tthayer/rv_drone/docs/ENGINE.md

# rv_drone drone engine

The engine runs on the LicheeRV Nano's C906 core in `src/engine/`. It is plain
C11 float code with no libm and no hardware access, so the Mac emulator (`emu/`)
runs exactly the same code and produces the same audio. This document
describes what it does, how it is driven, and how it runs on the Nano.
`docs/ARCHITECTURE.md` covers the board-level system.

| File | Contents |
|---|---|
| `src/engine/engine.c`, `engine.h` | voices, filter, effects, MIDI clock follower, `engine_render()` |
| `src/engine/params.c`, `params.h` | the parameter table: ranges, curves, units, formatting, CC map, clock divisions |
| `src/engine/osc.c`, `osc.h` | oscillator-bank kernels: scalar and RVV (XTheadVector), same math |
| `src/engine/dsp.h` | libm-free math: `dsp_exp2`, `dsp_mtof`, `dsp_sin1`, `dsp_tanh`, `dsp_noise`, `dsp_flush` |
| `src/ui/ui.c` | encoder pages, MIDI routing, presets, display drawing; calls into the engine |
| `src/app/main.c` (`render_block`) | Nano glue: renders one rvlink block, converts it to 24-bit, measures the time it takes |

## Signal flow

```
 per voice (x4) ------------------------------------------------------------
  osc 1..N (N = OSCS, 3-7)                          per-voice filter LFO
  sine -> polyBLEP saw (SHAPE)                      (free Hz, or synced)
  detune spread + drift LFO ---> pan (SPREAD) --+           |
  sub: sine one octave down (SUB, centre) ------+--> stereo SVF (LP/BP, RESO)
                                                    --> tanh drive (DRIVE)
                                                    --> envelope (ATTACK/RELEASE)
 ---------------------------------------------------------------------------
 sum of voices x mix gain (1 up to 4 voices, then 2/sqrt(n))
  --> chorus (2 modulated taps per side, CHORUS)
  --> feedback delay (stereo, cross-fed, damped, DELAY/FEEDBACK/DLY MIX)
  --> FDN reverb (8 lines, SIZE/DAMP/REVERB; REV MODE: hall, shimmer, freeze)
        ^-- pitch shifter (+12 / +7 / -12 st) on the wet sum, fed back (SHIMMER)
  --> loop recorder (capture the post-effects signal, add the loop playback)
  --> volume (VOLUME^2, smoothed) --> soft clip --> L/R float, about +-1
```

The engine works in **32-frame control blocks**. Pitches, pans, envelope
coefficients, filter coefficients, LFO phases and effect settings are worked
out once per control block. Oscillators, filters, the envelope and the
effects run per sample. `engine_render(l, r, n)` accepts any `n` and splits it
into control blocks internally.

## Voices

- **Sixteen voices** (`ENGINE_VOICES`, 4 until 2026-10-07). Each voice holds
  one MIDI note (plus TRANSPOSE). The engine
  starts **silent**: `engine_init()` plays nothing until a note arrives, from
  MIDI or the emulator's keyboard. `emu --wav` defaults to `--notes 38,45`
  (D2 + A2), so offline renders still have a drone. Until 2026-10-07 the boot
  latched D2 + A2, so the hardware made sound with no MIDI attached.
- **Voice allocation for a note-on:**
  1. the voice already playing that note (it retriggers);
  2. otherwise a silent voice;
  3. otherwise **steal** the quietest releasing voice, else the quietest held
     voice (ties go to the oldest). The stolen voice **fades out over 30 ms**
     (`STEAL_FADE_S`) and then starts the new note with fresh phases and an
     attack from zero. If it is already near silent (below 1e-3), it switches
     at once. Before 2026-10-07 a steal changed the voice's note instantly,
     cutting its tail off.

  A voice that starts from silence gets random oscillator phases and drift
  rates, so no two notes start identically. A note-off for a note still
  queued on a fading voice cancels it.
- **LATCH ON (the default):** note-offs are ignored. The first note-on after
  all keys have been released starts a new chord, releasing the previous one.
  This holds a drone chord with no sustain pedal.
- **LATCH OFF:** note-offs release their voice, so an external sequencer can
  gate notes. CC 123 (All Notes Off) releases everything in either mode.

### Oscillator bank

- **Kernel:** each voice's bank renders a whole control block into stereo
  buffers in one call (`osc_bank_scalar` or `osc_bank_rvv`). Phases are 32-bit
  fixed point (2^32 = one cycle), so wrapping is exact and costs nothing, and
  sample i's phase is `ph + i·inc`, which is easy to vectorise.
- **Oscillator count:** OSCS, 3 to 16 per voice (7 until 2026-10-07). On the
  Nano, plain-C mode (RVV off) caps it at 7 to stay real-time.
- **Detune:** the oscillators are spread linearly across ±DETUNE cents. Each
  one also has its own **drift LFO**: a sine of ±(DRIFT × 10) cents at a
  random rate of 0.05–0.17 Hz. This slow beating is what makes the drone move.
- **STACK** sets an interval and level for each oscillator, cycling through
  the mode's table. Detune and drift still apply on top. An oscillator pushed
  above 0.45·fs is muted rather than mistuned.

  | STACK | Intervals (semitones) | Weights |
  |---|---|---|
  | UNISON | 0 | 1 |
  | OCTAVES | 0, +12, −12, +24 | 1, .7, .8, .5 |
  | FIFTHS | 0, +7, +12, +19, −12, +24 | 1, .8, .7, .55, .75, .45 |
  | ORGAN | 0, +12, +19, +24, +28, +31, +36, −12 (8′ 4′ 2⅔′ 2′ 1⅗′ 1⅓′ 1′ 16′) | 1, .8, .6, .55, .45, .4, .35, .7 |
- **Waveform:** a crossfade from sine to **polyBLEP saw**, set by SHAPE
  (0 = pure sine, 1 = band-limited saw).
- **WAVE (source):** ANALOG (the morph above) or a **band-limited single-cycle
  wavetable** in DDR — SAW, SQUARE, ORGAN, or a CUSTOM cycle loaded from
  `WAVE.RAW`. Each table has 10 MIP levels (harmonic caps 512…1); the
  oscillator selects the level whose harmonics stay under Nyquist for its pitch,
  so there is no aliasing. The lookup is **scalar**: XTheadVector has no indexed
  load, so wavetable notes use the scalar path even when the RVV kernels are
  selected (SHAPE is ignored for a wavetable).
- **Stereo:** neighbouring oscillators are panned to opposite sides with an
  equal-power law; SPREAD sets the width.
- **Level:** the bank is normalised by roughly 1/√N, so changing OSCS doesn't
  jump the level.
- **Sub:** a sine one octave below the root, level SUB × 1.2, panned to the
  centre and added before the filter.

### Filter, drive, envelope

- **Filter:** a stereo **TPT state-variable filter** (Zavalishin topology:
  stable when modulated, no delay-free-loop problems).
  - MODE selects LP, or BP with its gain normalised to the peak.
  - The damping is k = 2 − 2·RESO, with RESO from 0 to 95 %.
  - The coefficient g = tan(π·fc/fs) comes from the `dsp_sin1` ratio.
- **Cutoff:** CUTOFF, smoothed per control block so encoder steps don't
  zipper, times 2^(MODDEPTH × 3 × lfo), so modulation reaches up to
  ±3 octaves. The result is clamped to 20 Hz … 0.42·fs.
- **Filter LFO:** one sine per voice.
  - Free-running, its rate is MODRATE × (1 + 0.13·voice index), so the voices
    drift apart.
  - Synced to MIDI clock, see below. Voices are then offset by ¼ cycle.
- **Drive:** `tanh_approx(x × (1 + 3·DRIVE)) / (1 + DRIVE)` on each channel
  after the filter.
- **Envelope:** a one-pole glide towards its target: the note's velocity gain
  (the MIDI velocity / 127, so 0.008…1) while the gate is on, or 0 while it is
  off. The per-sample coefficient 1 − e^(−1/τ) is computed with a series expansion for
  long times, because 1 − 2^(−tiny) loses all precision. Until 2026-10-07
  `dsp_exp2`'s Taylor error made every long ATTACK and RELEASE about 6× too
  short. The time
  constant is ATTACK/3 or RELEASE/3, so the level is about 95 % of the way
  there after ATTACK or RELEASE seconds. A voice is freed when its level falls
  below 1e-4 with the gate off.

## Effects (shared)

The summed voices are scaled by a smoothed mix gain into the effects chain:
1 for up to 4 sounding voices (as before), then 2/√n (0.5 at 16), so a full
chord doesn't push the output into the clipper. It used to be a fixed ×0.45,
now folded into the voice-path gain.

- **Chorus:**
  - Two linearly interpolated taps per channel, at 12 ms ± 4 ms.
  - Modulated by a 0.23 Hz LFO in quadrature (L and R a quarter-cycle apart).
  - Cross taps at 1.37× the opposite channel's delay.
  - Output: `out += CHORUS × 0.6 × (tap + cross tap)`.
- **Delay:**
  - Stereo with cross-fed feedback (ping-pong-like) and a one-pole lowpass in
    the loop, so repeats darken.
  - Up to 120 s; DELAY sets the time in free mode. The buffer is 2^23 samples
    per channel (~175 s, 64 MiB stereo) out of the spare DDR; the delay streams
    from it sequentially, so the CPU cost is unchanged.
  - The time glides (0.0005 per sample), so changing it bends the pitch like
    tape instead of clicking.
  - FEEDBACK goes up to 95 %; DLY MIX sets the wet level.
- **Reverb:** an 8-line **feedback delay network**.
  - Line lengths: primes from 1031 to 2969 samples, scaled by
    (0.5 + 1.3·SIZE).
  - Orthonormal Hadamard mixing (fast in-place butterflies, ×1/√8).
  - Each line has its own gain for an RT60 of 1.5 + 12·SIZE² seconds, and a
    one-pole damping lowpass set by DAMP.
  - Input goes to the lines with alternating signs. Even lines feed L, odd
    lines feed R. REVERB sets the wet level.
  - **REV MODE** picks how the reverb behaves:

    | Mode | What it does |
    |---|---|
    | HALL | the plain FDN above |
    | SHIM OCT | shimmer: the wet sum, shifted up 12 st, is fed back into the input |
    | SHIM 5TH | the same, shifted up 7 st (×1.4983) |
    | SUB OCT | the same, shifted down 12 st, a darker bloom |
    | FREEZE | input fades out (about 20 ms), line gains go to 0.99998 and damping off, so the current tail holds for minutes; the dry sound still plays on top |

  - **Shimmer pitch shifter:** two taps on a 8192-sample buffer of the wet
    sum (L+R). Each tap's delay sweeps across 4096 samples (85 ms) at a rate
    set by the pitch ratio, half a sweep apart, with Hann crossfades that sum
    to 1. The shifted signal goes through a one-pole lowpass (about 4.6 kHz),
    a one-pole highpass (about 77 Hz) and `tanh`, then into every line's
    input. SHIMMER scales it, smoothed so mode changes don't click. Repeated
    passes stack octaves (or fifths) upward, each quieter than the last.
  - Like any delay-line shifter it detunes a pure sine by a few Hz (the
    grain rate) and beats slightly; the reverb smears that into the shimmer.
    More taps or longer sweeps were tried and cancel the shifted tone on
    some notes.
  - **Feedback limit:** a host sweep (3-note chord, every shimmer mode,
    SIZE 0–1, DAMP 0 and 50 %, SHIMMER 100 %) found the loop sustains itself
    above a gain of 0.19 at worst (SHIM OCT, DAMP 0, SIZE 75 %). `SHIM_FB`
    is 0.15 at SHIMMER 100 %, so every tail still decays. The shifted band
    lands 6–16 dB below the played note.
- **Output:** volume is VOLUME², smoothed per sample, times `OUT_GAIN` (0.4),
  then `tanh_approx` soft-clips into ±1.
  - The gain is sized from measurement: the worst case (16 voices × 7 osc,
    drive 60 %, reso 90 %, VOLUME 100 %) peaks at about 2.7× full scale before
    this stage, so 0.4 lands it at −4 dBFS and the clipper is only a safety
    net. Default settings sit around −9 dBFS.
  - It was ×1.5 until 2026-10-07, which clipped hard even at 4 voices.
    Presets saved before then play about 11 dB quieter; the default VOLUME
    moved from 70 % to 85 % to compensate.

## Loop recorder

The LOOPER page records the post-effects output into a large buffer, loops it,
and layers overdubs — spare DDR, like the long delay. RAM is the only real
cost; the buffer streams sequentially.

- One buffer of 2^22 frames per channel (~87 s, 32 MiB stereo). The first
  record pass sets the length (stopped when REC is toggled off); left running,
  the buffer fills over ~87 s and then plays.
- **Capture point:** the post-effects signal, just before the master volume
  (`l`/`r` after the reverb in the signal flow above). Playback is summed back
  at the same point, so a loop sits at the same level as the live signal.
- **Overdub** plays the loop and adds the new input on top (`buf += in`), so
  passes layer without runaway feedback.
- **Transport & UI:** the LOOPER page's switches are REC, PLAY/STOP and DUB;
  encoder 1 picks the slot, and SAVE/LOAD stream the loop to/from the SD card
  (`LOOP0n.RAW`, raw float32: an L plane then an R plane; `build/emu/loops/` in
  the emulator). Starting REC again clears and re-records.
- **CPU:** one read and one write per sample per channel, streaming from DDR —
  negligible next to the delay.

## MIDI clock follower

The MicroFreak (or any MIDI clock master) sets the tempo. Pico B timestamps
every clock byte in its UART interrupt and forwards it to the Nano as an
rvpanel `CLOCK` packet. See `docs/ARCHITECTURE.md`, "Panel link".

- **Tempo:** the mean of the last 24 tick intervals (one beat at 24 PPQN),
  from Pico B's timestamps, so link jitter doesn't reach it. An interval over
  250 ms restarts the average. The tempo counts as valid once there are 4
  intervals and the last tick was under 0.5 s ago.
- **Beat position:** advances every control block at the measured tempo. On
  each tick it is pulled 25 % of the way onto the tick grid, or snapped if it
  is more than a beat off. **Start** resets it so the next tick is beat 0.
  Stop and Continue only switch the "running" indicator.
- **What the clock drives** (CLOCK page, SYNC = MIDI, with a valid tempo):
  - LFO DIV sets one filter-LFO cycle per ¼ beat, ½ beat, 1 beat, 2 beats,
    1 bar, 2 bars, 4 bars or 8 bars. The LFO phase comes straight from the beat
    position.
  - DLY DIV sets the delay to 1/16, 1/8, dotted 1/8, 1/4, dotted 1/4 or 1/2,
    capped at 2 s.
  - FREE in either setting keeps the Hz or millisecond parameter.
- **Without a clock** (no tick for 0.5 s), everything falls back to the free
  values. The header shows `120>BPM` while the clock is running and `120 BPM`
  while it is stopped.
- **Verified on hardware** (2026-10-07) with the MicroFreak as master. It
  only sends MIDI clock while its arpeggiator or sequencer is playing, and
  Utility → MIDI → Output dest must be MIDI or BOTH. The Nano tracked 176 BPM
  (about 70 ticks/s), and the LFO divider audibly locked to the bar.
- **Checked in emu:** at 120 BPM with 1 BAR, the filter-LFO period measures
  2.02 s. At 90 BPM with 2 beats, it measures 1.33 s.

## Parameters

Each parameter has a **normalised position** (0–1, which is what an encoder
moves and what presets store) and a **value** in its own unit (what the engine
uses). EXP parameters are spaced logarithmically. INT and ENUM parameters move
exactly one step per encoder click, and ENUMs wrap around.

| Page | Param | Range | Default | Curve | CC |
|---|---|---|---|---|---|
| OSC | DETUNE | 0–50 cents | 12 c | lin | 20 |
| OSC | DRIFT | 0–100 % (±10 c) | 30 % | lin | 21 |
| OSC | SHAPE | sine → saw | 60 % | lin | 22 |
| OSC | OSCS | 3–16 | 5 | int | 23 |
| OSC | SUB | 0–100 % | 30 % | lin | 24 |
| OSC | SPREAD | 0–100 % | 70 % | lin | 25 |
| FILTER | CUTOFF | 40 Hz–12 kHz | 900 Hz | exp | 26, **74** |
| FILTER | RESO | 0–95 % | 30 % | lin | 27, **71** |
| FILTER | MODRATE | 0.01–2 Hz | 0.07 Hz | exp | 28 |
| FILTER | MODDEPTH | 0–100 % (±3 oct) | 35 % | lin | 29, **1** |
| FILTER | DRIVE | 0–100 % | 25 % | lin | 30 |
| FILTER | MODE | LP / BP | LP | enum | 31 |
| SPACE | CHORUS | 0–100 % | 40 % | lin | 32, **93** |
| SPACE | DELAY | 20 ms–120 s | 850 ms | exp | 33 |
| SPACE | FEEDBACK | 0–95 % | 55 % | lin | 34 |
| SPACE | DLY MIX | 0–100 % | 25 % | lin | 35 |
| SPACE | SIZE | 0–100 % | 75 % | lin | 36 |
| SPACE | REVERB | 0–100 % | 45 % | lin | 37, **91** |
| AMP | ATTACK | 10 ms–20 s | 2 s | exp | 38, **73** |
| AMP | RELEASE | 50 ms–30 s | 4 s | exp | 39, **72** |
| AMP | LATCH | OFF / ON | ON | enum | 40 |
| AMP | TRANSPOS | −24…+24 st | 0 | int | 41 |
| AMP | DAMP | 0–100 % | 50 % | lin | 42 |
| AMP | VOLUME | 0–100 % (squared) | 85 % | lin | 43, **7** |
| MODES | SYNC | OFF / MIDI | MIDI | enum | 44 |
| MODES | LFO DIV | FREE, 1/4 … 8 BAR | FREE | enum | 45 |
| MODES | DLY DIV | FREE, 1/16 … 1/2 | FREE | enum | 46 |
| MODES | STACK | UNISON, OCTAVES, FIFTHS, ORGAN | UNISON | enum | 47 |
| MODES | REV MODE | HALL, SHIM OCT, SHIM 5TH, SUB OCT, FREEZE | HALL | enum | 48 |
| MODES | SHIMMER | 0–100 % (shimmer modes only) | 50 % | lin | 49 |
| WAVE | WAVE | ANALOG, SAW, SQUARE, ORGAN, CUSTOM | ANALOG | enum | 50 |

CC values 0–127 map to a position of 0–1. CC 123 is All Notes Off.

**UI** (the player's guide is `docs/CONTROLS.md`): the six encoders show the six parameters of the current page; each
display shows two. Pushing encoder 1 steps through OSC → FILTER → SPACE → AMP
→ MODES → PRESET. Pushing any other encoder resets its parameter to the
default. The PRESET page is described in the README ("SD card and presets"):
encoder 1 picks the slot, encoder 2 loads and encoder 3 saves. The right
display previews the selected slot's stored settings: cutoff/reso, shape/detune,
oscs/sub, delay (time or division)/feedback, reverb/size, attack/release. The
file is read when the page opens, when the slot changes and after a save,
never from the draw path.
Presets store every parameter's position by name, so adding a parameter later
doesn't break older files. Files written since 2026-10-07 carry a `preset v2`
header. Older v1 files stored OSCS as a position on the old 3–7 range, so they
are converted on load to the same oscillator count.

## Running on the Nano

- **Where it runs:** `render_block()` in `src/app/main.c` is the rvlink render
  callback. The audio link calls it **from the main loop** right after each
  SPI frame, to have the next 64-frame block ready before Pico A asks for it.
  It renders, clamps, converts to 24-bit left-aligned `int32` and times the
  work with `rdtime`.
- **Float stays out of interrupts.** The trap entry doesn't save FP
  registers, so the engine, `ui_*` and the parameter code must only run in
  main-loop context. Check with
  `riscv64-elf-objdump -d build/nano/rv_drone.elf`: FP instructions should
  appear only in engine, UI, params and render functions. `main()` sets
  `sstatus.FS`.
- **Concurrency:** UI events (encoders, MIDI, clock) also reach the engine
  from the main loop, so engine state never needs locking on the Nano. The
  emulator locks the SDL audio device around UI calls instead.
- **SD stalls:** long SD waits call `audio_link_poll()` as an idle hook, so
  rendering continues while a preset saves.
- **Latency:** Pico A's buffer is primed to 3 blocks. With one block in
  flight, that's about 5.3 ms from render to DAC (it was 6.7 ms at 4 blocks). MIDI note and parameter changes take effect at
  the next render, so they're quantised to block boundaries of 1.33 ms.
- **CPU cost** (C906, `-O2`, no vector instructions yet), per 64-frame block
  out of a 1333 µs budget:

  | Load | Time | CPU |
  |---|---|---|
  | silent (effects only) | ~93 µs | 7 % |
  | 2 voices × 5 osc (a D2 + A2 drone), M7 build | ~290 µs | 21 % |
  | 4 voices × 7 osc, M7 build | ~444 µs | 33 % |
  | 16 voices × 7 osc, RVV | ~390 µs | 29 % |
  | 16 voices × 7 osc, scalar | ~976 µs | 73 % |
  | **16 voices × 16 osc (worst case, console `w`), RVV** | **~648 µs** | **48 %** |
  | 16 voices × 16 osc, scalar, uncapped | ~1795 µs | 134 %, not real-time, hence the scalar cap of 7 |
  | 16 voices × 16 osc requested, scalar, capped at 7 | ~1001 µs | 75 % |

  The effects cost about 140 µs per block whatever the voice count. That figure
  is inferred from the measurements above, not measured on its own. The
  console prints the render average, maximum and load each second, and the
  right display's header shows the load.
- **Memory** (static `.bss`, about 65 MiB, mostly the delay; `.bss` is `NOLOAD`
  so `fip.bin` stays ~360 KB — the `.bss` zeroing at boot just takes a little
  longer):

  | Buffer | Size |
  |---|---|
  | delay | 2 × 8388608 floats = 64 MiB |
  | loop | 2 × 4194304 floats = 32 MiB |
  | wavetables | 4 × 10 × 1025 floats = 160 KiB |
  | reverb | 8 × 8192 floats = 256 KiB |
  | shimmer | 8192 floats = 32 KiB |
  | chorus | 2 × 2048 floats = 16 KiB |

- **Cores and caches** (SG2002 TRM, Diagram 2.1 "System Framework" and §2.3.1):
  - **main C906 @ 1.0 GHz** (what we run): 32 KB I-cache, 64 KB D-cache and
    **128 KB L2** (Diagram 2.1), vector + FPU. The §2.3.1 list mentions the L2
    only under the A53; the diagram shows it for the main C906 as well, most
    likely the same L2 serving whichever main core boots.
  - **Cortex-A53 @ 1.0 GHz**, the alternative main core chosen by a boot pin
    (GPIO_RTX / EPHY_RTX): 32/32 KB L1 + 128 KB L2, NEON + FPU.
  - **coprocessor C906 @ 700 MHz** (parked today): **16 KB I-cache, 16 KB
    D-cache, no L2** (Diagram 2.1), FPU, no vector unit.
  - **8051** (RTC domain): 25–300 MHz, 8 KB SRAM, for power management.
  - **Core clock** (`src/hal/cpuclk.c`, build option `CPU_MHZ`, default 1000):
    - **Reset default:** the TRM clock table gives `clk_c906_0` fpll / 2 =
      **750 MHz** (`div_clk_c906_0_1`, `clk_sel_0[23] = 0`).
    - **Measured (2026-10-07): the vendor FSBL already runs the core at
      1050 MHz.** It sets MPLL to 25 × 42 = 1050 MHz (`mpll_csr` 0x05548101),
      selects it through `div_clk_c906_0_0` (0x00010309) and sets
      `clk_sel_0` to 0x01800000. With `CPU_MHZ=1000` the boot sees "already
      within 10 %" and leaves it alone. Every CPU figure in this document is at
      1050 MHz.
    - **What boot does:** it measures the core clock (`rdcycle` against the
      25 MHz `rdtime` over 2.5 ms, with a trap probe in case S-mode can't read
      the cycle counter). With `CPU_MHZ=1000` it then moves the core to
      **MPLL / 1** via `div_clk_c906_0_0` (src 3 = MPLL, ÷1) and
      `clk_sel_0[23] = 1`, but only if all of these hold:
      1. MPLL is powered (`pll_g6_ctrl[0] = 0`);
      2. MPLL is locked (`pll_g6_status[16]`);
      3. MPLL computes to 900–1100 MHz from its registers (fractional
         synthesizer or integer mode);
      4. the core isn't bypassed to the crystal (`clk_byp_1[6]`).
    - **Afterwards:** it re-measures and switches back if the result is more
      than 10 % off target. The banner prints `cpuclk: C906 <before> MHz at boot
      -> <after> MHz (…)` plus the register values. Console `c` re-measures.
    - **Nothing else moves:** the UARTs, SPI2, SD and the timer have their own
      clocks.
  Working sets (reuse distance, the live data between a write and its
  read-back):

  | Stage | Live working set | Main C906 (64 KB L1D + 128 KB L2) | Coprocessor (16 KB L1D, no L2) |
  |---|---|---|---|
  | oscillators, filter, envelope | < 1 KB | L1 | L1, a good fit |
  | chorus | 16 KB | L1 / L2 | misses |
  | reverb | Σ line lengths × 4 B: ~70 KB at SIZE 75 %, ~85 KB at 100 % | fits L2 | misses |
  | delay | delay time × 2 ch × 4 B: 326 KB at 850 ms, 23 MB at 60 s | streams from DDR (sequential) | streams from DDR |

  - **Effects stay on the main core** (with the vector kernels).
  - **If the coprocessor is used,** its FPU suits voice or oscillator work in
    scalar C, which has a tiny working set. It would hand each block back as
    512 B with a cache clean and invalidate, since the L1s are not coherent.
  - **If profiling shows the delay is memory-bound,** store it as 16-bit or
    make sure the T-Head prefetcher is enabled.
  - **Large random-access tables** (wavetables, granular) belong on the main
    core and must fit its 128 KB L2.
  The delay, chorus and reverb read positions use integer index arithmetic, so
  the 32-bit write counters never lose precision over long runs.
- **Numerics:**

  | Function | Accuracy |
  |---|---|
  | `dsp_exp2` | relative error 8e-8 (degree-6 minimax; was a Taylor fit at 1e-4 until 2026-10-07) |
  | `dsp_sin1` | absolute error 0.0011 |
  | `dsp_tanh` | a rational soft clipper, deliberately not exact tanh (max difference 0.024) |

  Feedback paths flush values below 1e-15 to zero (`dsp_flush`), so
  denormals can't build up.

## SIMD (RVV) and profiling

- **Vector unit:** the C906 implements RVV **0.7.1** (T-Head "XTheadVector",
  VLEN 128). GCC 16 targets it with `-march=rv64gc_xtheadvector` and the
  standard `__riscv_*` intrinsics, which compile to `th.v*` instructions. It
  does **not** auto-vectorise for this target, so vector code is written by hand.
  Only `src/engine/osc.c` and `src/hal/vec.c` are compiled with that `-march`
  (Makefile, `BOARD=nano`), so no other code can pick up vector instructions.
- **Enabling it:** `vec_init()` (`src/hal/vec.c`) runs at boot.
  - It tries `th.vsetvli`, catching the illegal-instruction trap.
  - If that traps, it sets the vector-state field in `sstatus`, first at
    T-Head's position (bits 24:23), then at the RVV 1.0 position (bits 10:9),
    and retries.
  - The console reports the result (`simd: vector unit ok, VLEN 128, …`).
- **C906 scalar tuning:** the Nano build defaults to `C906_OPT=1`, which
  means `-march=rv64imafdc_zicsr_zifencei_xthead{ba,bb,bs,cmo,condmov,fmemidx,mac,memidx,mempair,sync}`
  plus `-mtune=thead-c906`. It is equivalent to `-mcpu=thead-c906`, so GCC uses
  T-Head's scalar extensions and the C906 pipeline model:
  - indexed float loads and stores (`th.flrw`/`th.fsrw`) for the delay-line
    and buffer taps;
  - conditional moves (`th.mveqz`/`th.mvnez`) instead of branches;
  - paired loads and stores (`th.ldd`/`th.sdd`).

  These need `mxstatus.THEADISAEE`, which the vendor FSBL sets; the M5
  cache-maintenance probe relies on it too. `C906_OPT=0` builds generic
  `rv64gc` for A/B timing. The boot banner shows which build is running
  (`rv_drone [c906]` or `[rv64gc]`), and a flags stamp forces a full rebuild
  when the setting changes.
- **Self-test before use:** at boot the Nano runs the scalar and RVV
  oscillator kernels on the same random 7-oscillator bank for 8 blocks and
  compares them. The RVV kernel is used only if the largest difference is under
  1e-4 and the phases match exactly. Otherwise the engine stays scalar.
- **The same rule as FP:** the trap entry saves no vector registers, so vector
  code runs only in main-loop context.
- **Profiling:** `engine_set_timer()` gives the engine a tick source (`rdtime`
  on the Nano, the SDL performance counter in emu). The engine then accumulates
  time per stage:
  - **osc:** the oscillator banks;
  - **voice:** sub-oscillator, filter, drive and envelope;
  - **chorus**, **delay** and **reverb**;
  - **total.**

  The Nano prints a `prof (us/64-frame block, rvv|scalar): …` line every
  second, and `emu --wav` prints the same breakdown for the host.
- **Measured on the C906** (2026-10-07, 1050 MHz), worst case 4 voices ×
  7 oscillators, in µs per 64-frame block (budget 1333):

  | Build | osc | voice | chorus | delay | reverb | total | CPU |
  |---|---|---|---|---|---|---|---|
  | M7 baseline (old kernel, generic) | | | | | | 444 | 33 % |
  | generic rv64gc, scalar | 135 | 63 | 15 | 8 | 138 | 387 | 29 % |
  | generic rv64gc, RVV | 27 | 63 | 15 | 8 | 137 | 279 | 21 % |
  | C906-tuned, scalar | 136 | 63 | 14 | 8 | 137 | 387 | 29 % |
  | C906-tuned, RVV | 28 | 62 | 14 | 8 | 137 | 278 | 21 % |
  | **C906-tuned, RVV, padded buffers** | **28** | 63 | 14 | 7 | **62** | **202** | **15 %** |

  The default 2-voice drone renders in 138 µs (10 %).
  - **The RVV oscillator kernel is 4.9× faster** than scalar.
  - **`-mcpu=thead-c906` tuning makes no measurable difference** (it's kept,
    since it costs nothing).
  - **The reverb was cache-set bound:** all 8 lines are written at the same
    index into power-of-two-sized arrays, so they collided in one D-cache set
    (about 130 ns per access). Padding each row by one 64 B line
    (`REV_PAD`, plus `DLY_PAD` between the delay's L/R) took it from 137 to
    62 µs, with bit-identical output (host WAV checksum unchanged).
  - **What's left:** the voice path (sub, filter, drive, envelope; 63 µs) and
    the reverb (62 µs) are now the largest stages. The candidates are 8-lane
    vector SVF/tanh for the voice path, and a closer look at the reverb's
    remaining memory traffic.
- **Host reference** (Apple M4, clang `-O2`, where the scalar kernels are
  auto-vectorised), worst case 4 voices × 7 oscillators, in µs per block:

  | osc | voice | chorus | delay | reverb | total |
  |---|---|---|---|---|---|
  | 1.33 | 1.61 | 0.46 | 0.20 | 0.55 | 4.89 |

  Reproduce the C906 table with `C906_OPT=0` or `1` at build time, crossed with
  the console's `v` key (scalar or RVV kernels) at run time, and `w` for the
  worst case.
- **Status:** **verified on hardware** (2026-10-07). The probe finds the vector
  unit off at boot and enables it via `sstatus.VS[24:23]` (VLEN 128). The
  boot self-test covers the oscillator and voice-lane kernels, with a largest
  difference of 1.8e-7.
- **Vector voice path** (`src/engine/voice.c`):
  - Each active voice contributes two lanes (L, R), up to 32.
  - Per sample, every lane's TPT SVF, saturator and envelope advance in one
    vector op. Lanes are processed in chunks of 8 (e32/m2) with state and
    coefficients held in registers for the whole block.
  - The sub-oscillator now runs as a one-oscillator sine bank through the osc
    kernel.
  - Output matches the previous engine to −107 dB (host render diff).
  - **16 voices × 7 osc** on the C906, in µs per block:

    | Kernels | osc | voice | chorus | delay | reverb | total | CPU |
    |---|---|---|---|---|---|---|---|
    | RVV | 128 | 51 | 13 | 7 | 63 | 390 | 29 % |
    | scalar | 625 | 139 | 14 | 7 | 63 | 976 | 73 % |

    The voice path is 2.7× faster vectorised and the oscillators 4.9×.
- **Shimmer cost** (2026-10-07, Nano, console `r`): the reverb stage takes
  67 µs per block in HALL and FREEZE and 79–80 µs in the three shimmer modes,
  so shimmer adds about 13 µs (1 % CPU), only while it is selected.
  Measured with `w` in SHIM 5TH (16 voices × 16 osc, STACK FIFTHS): **667 µs
  average, 697 µs worst block, 50 %** of the 1333 µs budget, with no Pico A
  underruns. The shifter runs as a per-block pre-pass ahead of
  the reverb loop; offsetting its buffer by 9 cache lines made no difference,
  so the cost is arithmetic, not cache aliasing.

## Working on the engine

- **Listen on the Mac:** `make emu`, then `build/emu/rv_drone_emu`. The mouse
  wheel turns the encoders, the keyboard plays notes, and `k` toggles a test
  clock.
- **Check without listening:** `build/emu/rv_drone_emu --wav out.wav --set NAME=value --clock BPM`
  prints peak, RMS, DC and a NaN count. `.venv` has numpy for spectrum or
  modulation checks.
- **Adding a parameter:**
  1. Append it to the enum in `params.h`, so its position is also its CC
     offset (CC 20 + id).
  2. Add its row in `params.c`. The last page may have fewer than six
     parameters.
  3. Use `E.p[...]` in `engine.c`.
  4. Update this document's table and the CC list in `docs/ARCHITECTURE.md`.

  Presets pick it up automatically.
- **Tests:** `make test-presets` runs a preset round trip through the UI and
  engine, including v1 → v2 OSCS conversion. `make test-engine` checks:
  - `dsp_exp2` accuracy;
  - envelope release timing;
  - that stolen voices fade out before switching notes;
  - STACK partials, by Goertzel energy at 110/220/440/880 Hz;
  - each shimmer mode's shifted band (±30 Hz) is >10× HALL's, and at the
    worst-case loop gain every shimmer tail decays (rms at 29 s < 1 % of 2 s);
  - FREEZE holds the tail (> 70 % at 20 s) where HALL dies away.
- **Measure on hardware:** console `w` sets up the worst-case load. The
  console's `engine:` and `prof` lines show the render time, overall and per
  stage. `v` switches between the scalar and RVV kernels; `x` reruns the
  kernel self-test.
