tthayer/rv_drone/docs/wiring/panel.png

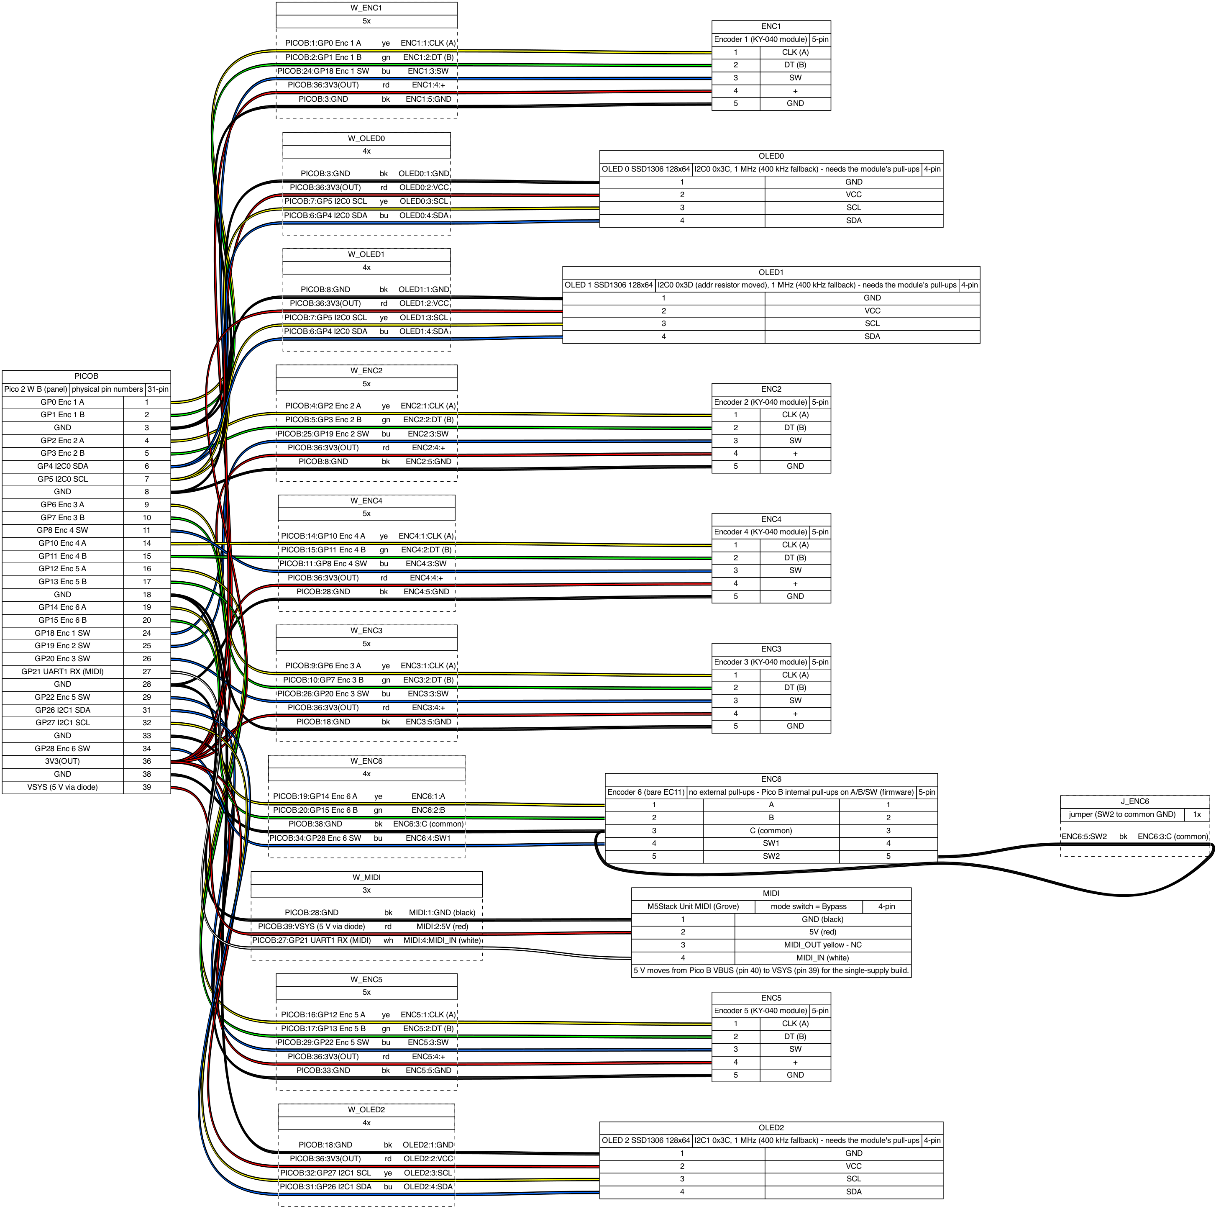
docs/wiring/panel.png
