tthayer/rv_drone/docs/wiring/system.png

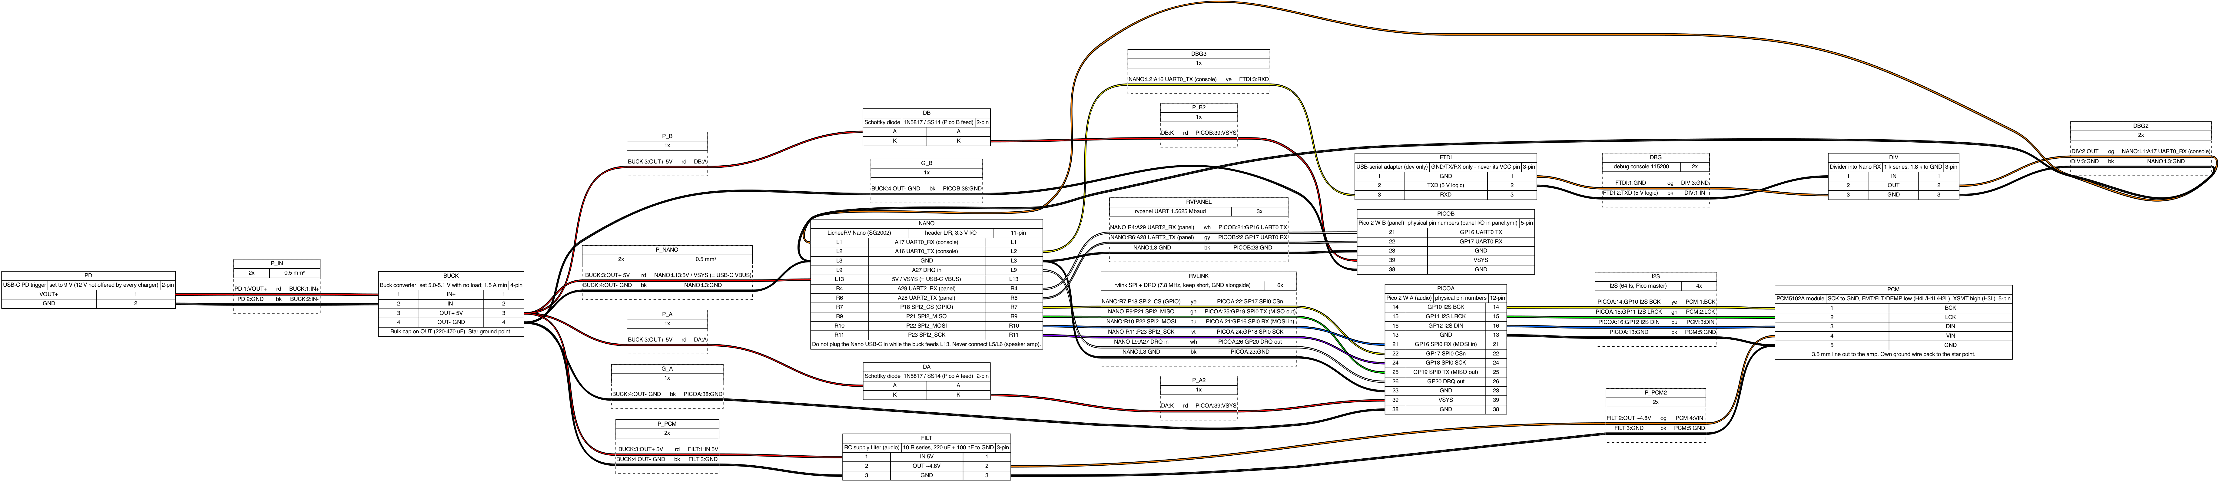
docs/wiring/system.png
