tthayer/rv_drone/src/app/preset_fs.c

#include "preset_fs.h"
#include "ff.h"
#include "diskio.h"
#include "sd.h"
#include "uart.h"
#include "osc.h"
#include "engine.h"
#include "conv.h"

static FATFS fs;
static int mounted;

int preset_fs_mount(void)
{
    if (mounted) return 0;
    FRESULT r = f_mount(&fs, "", 1);
    if (r != FR_OK) return (int)r;
    f_mkdir("/presets");                     /* FR_EXIST is fine */
    mounted = 1;
    return 0;
}

static void path(char *p, const char *name)
{
    const char *d = "/presets/";
    while (*d) *p++ = *d++;
    while (*name) *p++ = *name++;
    *p = 0;
}

static int st_read(const char *name, char *buf, int max)
{
    if (preset_fs_mount()) return -1;
    char p[24];
    path(p, name);
    FIL f;
    FRESULT r = f_open(&f, p, FA_READ);
    if (r == FR_NO_FILE) return -2;
    if (r != FR_OK) { mounted = 0; return -1; }
    UINT n = 0;
    r = f_read(&f, buf, (UINT)max, &n);
    f_close(&f);
    return r == FR_OK ? (int)n : -1;
}

static int st_write(const char *name, const char *buf, int len)
{
    if (preset_fs_mount()) return -1;
    char p[24];
    path(p, name);
    FIL f;
    if (f_open(&f, p, FA_WRITE | FA_CREATE_ALWAYS) != FR_OK) { mounted = 0; return -1; }
    UINT n = 0;
    FRESULT r = f_write(&f, buf, (UINT)len, &n);
    FRESULT c = f_close(&f);                 /* flushes FAT + directory */
    return (r == FR_OK && c == FR_OK && n == (UINT)len) ? 0 : -1;
}

const ui_store_t preset_fs_store = { st_read, st_write };

int preset_fs_format(void)
{
    static BYTE work[32768];
    mounted = 0;
    f_mount(0, "", 0);
    if (disk_initialize(0) & STA_NOINIT) return -1;
    MKFS_PARM opt = { FM_FAT32, 0, 0, 0, 0 };
    FRESULT r = f_mkfs("", &opt, work, sizeof work);
    if (r != FR_OK) return (int)r;             /* FRESULT 1..19 */
    int m = preset_fs_mount();
    return m ? 100 + m : 0;                    /* 100+: formatted, mount failed */
}

/* --- root-file streaming for the in-place firmware updater ---------------
 * The updater uses one file at a time; a failed I/O marks the volume
 * unmounted so the next call re-initialises the card. */
static FIL root_fil;
static int root_open_f;

int preset_fs_root_open(const char *name, int for_write)
{
    if (preset_fs_mount()) return -1;
    if (root_open_f) { f_close(&root_fil); root_open_f = 0; }
    FRESULT r = f_open(&root_fil, name, for_write ? (FA_WRITE | FA_CREATE_ALWAYS) : FA_READ);
    if (r == FR_OK) { root_open_f = 1; return 0; }
    if (r == FR_NO_FILE) return -2;
    mounted = 0;
    return -1;
}

int preset_fs_root_write(const void *buf, unsigned len)
{
    if (!root_open_f) return -1;
    UINT n = 0;
    FRESULT r = f_write(&root_fil, buf, (UINT)len, &n);
    if (r != FR_OK || n != (UINT)len) { mounted = 0; return -1; }
    return 0;
}

int preset_fs_root_read(void *buf, unsigned len, unsigned *got)
{
    if (!root_open_f) return -1;
    UINT n = 0;
    FRESULT r = f_read(&root_fil, buf, (UINT)len, &n);
    *got = (unsigned)n;
    if (r != FR_OK) { mounted = 0; return -1; }
    return 0;
}

int preset_fs_root_close(void)
{
    if (!root_open_f) return 0;
    FRESULT r = f_close(&root_fil);
    root_open_f = 0;
    return r == FR_OK ? 0 : -1;
}

int preset_fs_root_size(const char *name, uint32_t *size)
{
    if (preset_fs_mount()) return -1;
    FILINFO fi;
    if (f_stat(name, &fi) != FR_OK) return -1;
    *size = (uint32_t)fi.fsize;
    return 0;
}

int preset_fs_root_unlink(const char *name)
{
    if (preset_fs_mount()) return -1;
    FRESULT r = f_unlink(name);
    if (r == FR_OK || r == FR_NO_FILE) return 0;
    mounted = 0;
    return -1;
}

int preset_fs_root_rename(const char *from, const char *to)
{
    if (preset_fs_mount()) return -1;
    if (f_rename(from, to) != FR_OK) { mounted = 0; return -1; }
    return 0;
}

/* Loop-recorder slots: LOOP0n.RAW holds an L plane then an R plane of float32. */
static void loop_name(int slot, char *dst)
{
    static const char h[] = "/LOOP0";
    for (int i = 0; i < 6; i++) dst[i] = h[i];
    dst[6] = (char)('0' + slot);
    dst[7] = '.'; dst[8] = 'R'; dst[9] = 'A'; dst[10] = 'W'; dst[11] = 0;
}

int preset_fs_loop_save(int slot, const float *l, const float *r, uint32_t frames)
{
    if (slot < 1 || slot > 9 || !frames) return -1;
    char name[12];
    loop_name(slot, name);
    if (preset_fs_root_open(name, 1) != 0) return -1;
    int rc = 0;
    if (preset_fs_root_write(l, frames * sizeof(float)) != 0) rc = -1;
    else if (preset_fs_root_write(r, frames * sizeof(float)) != 0) rc = -1;
    if (preset_fs_root_close() != 0) rc = -1;
    return rc;
}

int preset_fs_loop_load(int slot, float *l, float *r, uint32_t max_frames, uint32_t *frames)
{
    if (slot < 1 || slot > 9) return -1;
    char name[12];
    loop_name(slot, name);
    uint32_t sz = 0;
    if (preset_fs_root_size(name, &sz) != 0) return -2;      /* no such file */
    uint32_t n = sz / (2 * sizeof(float));
    if (n > max_frames) n = max_frames;
    if (!n) return -3;
    if (preset_fs_root_open(name, 0) != 0) return -1;
    unsigned got = 0;
    int rc = 0;
    if (preset_fs_root_read(l, n * sizeof(float), &got) != 0 || got != n * sizeof(float)) rc = -1;
    else if (preset_fs_root_read(r, n * sizeof(float), &got) != 0 || got != n * sizeof(float)) rc = -1;
    preset_fs_root_close();
    if (rc == 0) *frames = n;
    return rc;
}

/* WAVE.RAW at the card root: one single cycle of float32, loaded into the
 * CUSTOM wavetable. Absent file (or too short) leaves the CUSTOM default. */
int preset_fs_wavetable_load(void)
{
    static float buf[1024];
    if (preset_fs_root_open("/WAVE.RAW", 0) != 0) return -1;
    unsigned got = 0;
    if (preset_fs_root_read(buf, sizeof buf, &got) != 0) { preset_fs_root_close(); return -1; }
    preset_fs_root_close();
    int n = (int)(got / sizeof(float));
    if (n < 8) return -2;
    osc_wavetable_set_custom(buf, n);
    return 0;
}

/* IR.RAW at the card root: a mono float32 impulse response, normalised to peak
 * 1 and installed into the CONV reverb. Absent/short file keeps the built-in. */
int preset_fs_ir_load(void)
{
    static float buf[CONV_P * CONV_B];
    if (preset_fs_root_open("/IR.RAW", 0) != 0) return -1;
    unsigned got = 0;
    if (preset_fs_root_read(buf, sizeof buf, &got) != 0) { preset_fs_root_close(); return -1; }
    preset_fs_root_close();
    int n = (int)(got / sizeof(float));
    if (n < 8) return -2;
    engine_ir_set(buf, n);          /* the engine normalises by energy */
    return 0;
}

void preset_fs_info(void)
{
    int m = preset_fs_mount();
    const sd_info_t *i = sd_info();
    uart_puts("sd: ");
    if (!i->sectors) {
        uart_puts("no card (mount ");
        uart_put_dec((uint64_t)m);
        uart_puts(")\n");
        sd_dump();
        return;
    }
    uart_put_dec(i->sectors / 2048);
    uart_puts(" MiB, ");
    uart_puts(i->sdhc ? "SDHC/XC, " : "SDSC, ");
    uart_puts(i->bus4 ? "4-bit, " : "1-bit, ");
    uart_put_dec(i->clk_hz / 1000);
    uart_puts(" kHz (base ");
    uart_put_dec(i->base_hz / 1000000);
    uart_puts(" MHz); ");
    if (m) {
        uart_puts("mount failed (FRESULT ");
        uart_put_dec((uint64_t)m);
        uart_puts("; 'F' twice to format)\n");
        return;
    }
    DWORD fre;
    FATFS *pfs;
    if (f_getfree("", &fre, &pfs) == FR_OK) {
        uart_puts(pfs->fs_type == FS_FAT32 ? "FAT32, " : "FAT, ");
        uart_put_dec((uint64_t)fre * pfs->csize / 2048);
        uart_puts(" MiB free\n");
    } else {
        uart_puts("mounted\n");
    }
}
