tthayer/rv_drone/src/hal/uart.c

/* Polled 16550-style UART. Baud/divisor is left as OpenSBI/FSBL set it. */
#include "uart.h"
#include "board.h"
#include "plic.h"

#define UART_THR 0   /* transmit holding */
#define UART_LSR 5   /* line status */
#define UART_RBR 0   /* receive buffer */
#define UART_IER 1   /* interrupt enable */
#define UART_IIR 2   /* interrupt identity (read) */
#define UART_USR 31  /* DW: UART status; reading clears busy-detect */
#define IIR_BUSY 0x7
#define IER_ERBFI 0x01
#define LSR_DR   0x01
#define LSR_THRE 0x20

#define UART_LCR 3   /* line control; bit 7 = DLAB (DLL/DLH access) */
#define UART_DLL 0   /* divisor latch low (DLAB) */
#define UART_DLH 1   /* divisor latch high (DLAB) */
#define LSR_TEMT 0x40

/* Power of 2; SPSC: ISR writes head, main writes tail. Sized to ride out a
 * blocking SD write during the 1.5625 Mbaud firmware upload (a 512 B payload
 * at that rate is ~3.3 ms). */
#define RX_N 512
static volatile uint8_t rx_buf[RX_N];
static volatile uint32_t rx_head, rx_tail;

static inline volatile uint8_t *reg(unsigned n)
{
    return (volatile uint8_t *)(BOARD_UART_BASE + ((uintptr_t)n << BOARD_UART_SHIFT));
}

/* TX: polled until uart_async_tx() is on; then a ring drained from the 1 kHz
 * tick, at most 16 bytes per tick into the (empty) TX FIFO: 16 kB/s against the
 * 11.5 kB/s line, so printing never stalls the caller. Single producer
 * (non-ISR code), single consumer (tick). Full ring: drop and count. */
#define TX_N 4096
static volatile uint8_t tx_buf[TX_N];
static volatile uint32_t tx_head, tx_tail;
static volatile int tx_async;
uint32_t uart_tx_dropped;

static void putc_raw(uint8_t c)
{
    while (!(*reg(UART_LSR) & LSR_THRE))
        ;
    *reg(UART_THR) = c;
}

static void putc_one(uint8_t c)
{
    if (!tx_async) {
        putc_raw(c);
        return;
    }
    uint32_t h = tx_head;
    if (h - tx_tail >= TX_N) {
        uart_tx_dropped++;
        return;
    }
    tx_buf[h % TX_N] = c;
    tx_head = h + 1;
}

void uart_putc(char c)
{
    if (c == '\n')
        putc_one('\r');
    putc_one((uint8_t)c);
}

void uart_async_tx(int on) { tx_async = on; }

void uart_tx_drain(void)
{
    if (!(*reg(UART_LSR) & LSR_THRE))           /* FIFO not yet empty */
        return;
    uint32_t t = tx_tail;
    for (int n = 0; n < 16 && t != tx_head; n++, t++)
        *reg(UART_THR) = tx_buf[t % TX_N];
    tx_tail = t;
}

/* Fault path: drop back to polled output and flush what is queued. */
void uart_sync(void)
{
    tx_async = 0;
    while (tx_tail != tx_head) {
        putc_raw(tx_buf[tx_tail % TX_N]);
        tx_tail = tx_tail + 1;
    }
}

void uart_puts(const char *s)
{
    while (*s)
        uart_putc(*s++);
}

void uart_put_hex(uint64_t v)
{
    uart_puts("0x");
    for (int i = 60; i >= 0; i -= 4)
        uart_putc("0123456789abcdef"[(v >> i) & 0xf]);
}

void uart_put_dec(uint64_t v)
{
    char buf[21];
    int n = 0;
    do {
        buf[n++] = (char)('0' + v % 10);
        v /= 10;
    } while (v);
    while (n)
        uart_putc(buf[--n]);
}

uint32_t uart_isr_count, uart_busy_count;

static void uart_rx_isr(void)
{
    uart_isr_count++;
#ifdef BOARD_UART_DW
    if ((*reg(UART_IIR) & 0xf) == IIR_BUSY) {   /* DW busy-detect: clear via USR */
        (void)*reg(UART_USR);
        uart_busy_count++;
    }
#endif
    while (*reg(UART_LSR) & LSR_DR) {
        uint8_t c = *reg(UART_RBR);
        uint32_t h = rx_head;
        if (h - rx_tail < RX_N) {   /* drop on full */
            rx_buf[h % RX_N] = c;
            rx_head = h + 1;
        }
    }
}

void uart_enable_rx_irq(void)
{
#ifdef BOARD_UART_DW
    (void)*reg(UART_USR);                       /* clear stale busy-detect */
#endif
    (void)*reg(UART_IIR);
    while (*reg(UART_LSR) & LSR_DR)
        (void)*reg(UART_RBR);
    plic_register(BOARD_UART_IRQ, uart_rx_isr);
    *reg(UART_IER) |= IER_ERBFI;
}

int uart_getc_nonblock(void)
{
    uint32_t t = rx_tail;
    if (t == rx_head)
        return -1;
    int c = rx_buf[t % RX_N];
    rx_tail = t + 1;
    return c;
}

void uart_dump_regs(void)
{
    uart_puts(" ier=");  uart_put_hex(*reg(UART_IER));
    uart_puts(" iir=");  uart_put_hex(*reg(UART_IIR));
    uart_puts(" lsr=");  uart_put_hex(*reg(UART_LSR));
#ifdef BOARD_UART_DW
    uart_puts(" usr=");  uart_put_hex(*reg(UART_USR));
#endif
}

uint32_t uart_divisor(void)
{
    uint8_t lcr = *reg(UART_LCR);
    *reg(UART_LCR) = lcr | 0x80;              /* DLAB: DLL/DLH */
    uint32_t div = (uint32_t)*reg(UART_DLL) | (uint32_t)*reg(UART_DLH) << 8;
    *reg(UART_LCR) = lcr;
    return div;
}

/* Reprogram the console baud (both directions). The line must be idle: waits
 * for the transmitter to drain so no byte goes out at the wrong rate. */
void uart_set_divisor(uint32_t div)
{
    while (!(*reg(UART_LSR) & LSR_TEMT))
        ;
    uint8_t lcr = *reg(UART_LCR);
    *reg(UART_LCR) = lcr | 0x80;
    *reg(UART_DLL) = (uint8_t)div;
    *reg(UART_DLH) = (uint8_t)(div >> 8);
    *reg(UART_LCR) = lcr;
}

/* Read-only report of the console's real baud rate. The UART clock is
 * clk_cam0_200, shared by UART0..4 (SG2002 TRM clock chapter,
 * clksource_preset_freq_div_param: clk_uart0..4 <- clk_cam0_200, preset xtal 25 MHz):
 * xtal when clk_byp_0[16] = 1 (the reset default), else div_clk_cam0_200 (0x0A8:
 * [9:8] src 0 = xtal, 1 = DISPPLL per the TRM register table; [3] use the
 * [20:16] factor). The vendor clk-cv181x.c lists the parents as {osc, osc,
 * disppll} instead; this follows the TRM. Reads the divisor latch (DLAB briefly
 * set, line idle, polled mode). Call before uart_async_tx(1). */
void uart_report_clock(void)
{
#ifdef BOARD_NANO
    while (!(*reg(UART_LSR) & LSR_TEMT))
        ;
#ifdef BOARD_UART_DW
    for (int i = 0; i < 100000 && (*reg(UART_USR) & 1); i++)
        ;
#endif
    uint8_t lcr = *reg(UART_LCR);
    *reg(UART_LCR) = lcr | 0x80;
    uint32_t div = (uint32_t)*reg(UART_DLL) | (uint32_t)*reg(UART_DLH) << 8;
    *reg(UART_LCR) = lcr;
    uint32_t byp = *(volatile uint32_t *)(uintptr_t)(BOARD_CLKGEN_BASE + 0x030);
    uint32_t dcam = *(volatile uint32_t *)(uintptr_t)(BOARD_CLKGEN_BASE + 0x0A8);
    /* xtal if bypassed, or if the divider's source is xtal (0) with factor 1. */
    uint32_t src = (dcam >> 8) & 3, fac = (dcam >> 16) & 31;
    int xtal = ((byp >> 16) & 1) || (src == 0 && fac <= 1);
    uart_puts("uart: clk_cam0_200 ");
    if (xtal) {
        uart_puts(((byp >> 16) & 1) ? "= xtal 25 MHz (bypass)" : "= osc 25 MHz (src 0, /1)");
    } else {
        uart_puts("from src ");
        uart_put_dec(src);
        uart_puts(" / ");
        uart_put_dec(fac);
    }
    uart_puts(" (div_clk_cam0_200 ");
    uart_put_hex(dcam);
    uart_puts("); UART0 divisor ");
    uart_put_dec(div);
    if (xtal && div) {
        uint32_t baud = 25000000u / (16u * div);
        int32_t ppm = (int32_t)(((int64_t)baud - 115200) * 1000000 / 115200);
        uart_puts(" -> ");
        uart_put_dec(baud);
        uart_puts(" baud (");
        if (ppm < 0) { uart_putc('-'); ppm = -ppm; }
        uart_put_dec((uint64_t)(ppm / 10000));
        uart_putc('.');
        uart_put_dec((uint64_t)((ppm / 1000) % 10));
        uart_puts("% vs 115200)");
    }
    uart_putc('\n');
#endif
}
