tthayer/rv_drone/src/app/preset_fs.h

#ifndef PRESET_FS_H
#define PRESET_FS_H
#include <stdint.h>
#include "ui.h"

/* ui_store_t on FatFs: files in /presets on the SD card. Mounts lazily (and
 * again after a failure), so a card inserted later is picked up. */
extern const ui_store_t preset_fs_store;
int  preset_fs_mount(void);     /* 0 = mounted, else FRESULT / sd_init step */
int  preset_fs_format(void);    /* f_mkfs (FAT32, one MBR partition) + /presets */
void preset_fs_info(void);      /* card + volume summary to the console */

/* Root-file streaming for the in-place firmware updater (firmware_update.c):
 * stage an image at the card root, verify it, then swap it in. One file open
 * at a time. All return 0 on success and -1 on I/O error; open also returns
 * -2 when the file does not exist. */
int preset_fs_root_open(const char *name, int for_write);
int preset_fs_root_write(const void *buf, unsigned len);
int preset_fs_root_read(void *buf, unsigned len, unsigned *got);
int preset_fs_root_close(void);
int preset_fs_root_size(const char *name, uint32_t *size);
int preset_fs_root_unlink(const char *name);
int preset_fs_root_rename(const char *from, const char *to);

/* Loop-recorder slots (LOOP0n.RAW at the card root): raw float32, an L plane
 * then an R plane of `frames` samples each. */
int preset_fs_loop_save(int slot, const float *l, const float *r, uint32_t frames);
int preset_fs_loop_load(int slot, float *l, float *r, uint32_t max_frames, uint32_t *frames);

/* WAVE.RAW (one float32 cycle) into the CUSTOM wavetable; 0 ok. */
int preset_fs_wavetable_load(void);

/* IR.RAW (a mono float32 impulse response) into the CONV reverb; 0 ok. */
int preset_fs_ir_load(void);
#endif
