tthayer/rv_drone/src/hal/uart.h

#ifndef UART_H
#define UART_H
#include <stdint.h>

void uart_putc(char c);
void uart_puts(const char *s);
void uart_put_hex(uint64_t v);   /* "0x" + 16 digits */
void uart_put_dec(uint64_t v);

void uart_async_tx(int on);      /* queue TX; uart_tx_drain() from the tick */
void uart_tx_drain(void);
void uart_sync(void);            /* back to polled; flush queue (fault path) */
extern uint32_t uart_tx_dropped;

void uart_enable_rx_irq(void);   /* IER.ERBFI + PLIC registration */
int uart_getc_nonblock(void);    /* -1 if empty */

uint32_t uart_divisor(void);           /* current console divisor (DLL/DLH) */
void uart_set_divisor(uint32_t div);   /* reprogram baud; waits for the line to drain */

extern uint32_t uart_isr_count, uart_busy_count;
void uart_dump_regs(void);
void uart_report_clock(void);    /* console's real baud + UART clock source (read-only) */
#endif
