tthayer/rv_drone/emu/test_engine.c

/* Host tests for engine behaviour that once regressed silently:
 *  1. dsp_exp2 accuracy (Taylor coefficients made envelopes ~6x too short).
 *  2. Envelope timing: RELEASE r -> level e^(-t/(r/3)) after the note-off.
 *  3. Voice stealing: a stolen voice fades out before its new note starts.
 *  4. STACK intervals land on the expected partials.
 *  5. Shimmer: each mode adds energy at its shifted pitch, and the feedback
 *     loop decays at its worst-case settings instead of sustaining itself.
 *  6. FREEZE holds the reverb; HALL lets it die away.
 *  7. Velocity scales the note level; velocity 0 is a note off.
 *  8. Delay length: the echo lands at the set time, including 30 s.
 *  9. Loop recorder: record -> loop -> periodic -> overdub.
 * 10. Wavetable oscillator: band-limited (no harmonics above Nyquist).
 * 11. FFT: round-trip identity; an impulse transforms to a flat spectrum.
 * 12. Convolution: partitioned FFT convolution matches a direct FIR.
 * 13. Convolution reverb (REV MODE = CONV): a burst leaves a decaying tail. */
#include <math.h>
#include <stdio.h>
#include "dsp.h"
#include "engine.h"
#include "params.h"
#include "fft.h"
#include "conv.h"

static int fails;
#define CHECK(c, ...) do { if (!(c)) { printf("FAIL: "); printf(__VA_ARGS__); printf("\n"); fails++; } } while (0)

#define SR 48000
static float tl[SR * 32], tr[SR * 32];

/* Goertzel magnitude per sample of one second starting at a. */
static double tone(const float *b, int a, double f)
{
    double w = 2 * 3.14159265358979 * f / SR, c = 2 * cos(w), s1 = 0, s2 = 0;
    for (int i = a; i < a + SR; i++) { double s0 = b[i] + c * s1 - s2; s2 = s1; s1 = s0; }
    return sqrt(s1 * s1 + s2 * s2 - c * s1 * s2) / SR;
}

/* Energy within +-30 Hz of f: a delay-line shifter lands a few Hz off pitch. */
static double band(const float *b, int a, double f)
{
    double e = 0;
    for (double g = f - 30; g <= f + 30; g += 1) { double m = tone(b, a, g); e += m * m; }
    return sqrt(e);
}

static double rms(const float *b, int a)
{
    double e = 0;
    for (int i = a; i < a + SR; i++) e += (double)b[i] * b[i];
    return sqrt(e / SR);
}

/* One plain voice into the reverb only: sines, no detune, chorus or delay. */
static void plain_setup(int mode, float size, float damp)
{
    engine_init(SR);
    engine_set_param(P_LATCH, 0); engine_set_param(P_ATTACK, 0.01f); engine_set_param(P_RELEASE, 0.3f);
    engine_set_param(P_OSCS, 3); engine_set_param(P_DETUNE, 0); engine_set_param(P_DRIFT, 0);
    engine_set_param(P_SHAPE, 0); engine_set_param(P_SUB, 0); engine_set_param(P_SPREAD, 0);
    engine_set_param(P_CUTOFF, 12000); engine_set_param(P_FMOD_DEPTH, 0); engine_set_param(P_DRIVE, 0);
    engine_set_param(P_CHORUS, 0); engine_set_param(P_DLY_MIX, 0); engine_set_param(P_REV_MIX, 1);
    engine_set_param(P_REV_SIZE, size); engine_set_param(P_DAMP, damp);
    engine_set_param(P_REV_MODE, mode); engine_set_param(P_SHIMMER, 1.0f);
}

/* Renders `secs` seconds into tl/tr; notes off at off_s, mode -> mode_to at mode_s. */
static void run(const int *notes, int nn, int secs, float off_s, float mode_s, int mode_to)
{
    for (int i = 0; i < nn; i++) engine_note_on(notes[i], 100);
    for (int s = 0; s < secs * SR; s += 32) {
        if (s == (int)(mode_s * SR) / 32 * 32) engine_set_param(P_REV_MODE, mode_to);
        if (s == (int)(off_s * SR) / 32 * 32)
            for (int i = 0; i < nn; i++) engine_note_off(notes[i]);
        engine_render(tl + s, tr + s, 32);
    }
}

int main(void)
{
    /* 1. exp2 */
    double worst = 0;
    for (int i = -3000; i <= 3000; i++) {
        float x = (float)i / 100.0f;
        double e = fabs(dsp_exp2(x) / exp2(x) - 1.0);
        if (e > worst) worst = e;
    }
    for (int i = 1; i <= 1000; i++) {                 /* tiny negative exponents */
        float x = -(float)i * 1e-6f;
        double e = fabs(dsp_exp2(x) / exp2(x) - 1.0);
        if (e > worst) worst = e;
    }
    CHECK(worst < 2e-7, "dsp_exp2 rel error %.2e", worst);

    /* 2. release timing: note on (fast attack), off at 0.1 s, RELEASE 4 s.
     * Full velocity, so the envelope peak is 1.0 and the level is the bare
     * exponential (velocity scaling is covered in test 7). */
    engine_init(48000);
    engine_set_param(P_LATCH, 0);
    engine_set_param(P_ATTACK, 0.01f);
    engine_set_param(P_RELEASE, 4.0f);
    float l[32], r[32];
    engine_note_on(60, 127);
    int note; float env = 0;
    for (long s = 0; s < 48000 * 3 / 2; s += 32) {
        if (s == 4800) engine_note_off(60);
        engine_render(l, r, 32);
    }
    engine_voice_info(0, &note, &env);
    double want = exp(-1.4 / (4.0 / 3.0));               /* 1.4 s of release */
    CHECK(fabs(env - want) < 0.03, "release env %.3f, want %.3f", env, want);

    /* 3. stealing: 24 rising notes, 16 voices fill with release tails */
    engine_init(48000);
    engine_set_param(P_LATCH, 0);
    engine_set_param(P_ATTACK, 0.01f);
    engine_set_param(P_RELEASE, 4.0f);
    int pn[ENGINE_VOICES]; float pe[ENGINE_VOICES];
    for (int i = 0; i < ENGINE_VOICES; i++) { pn[i] = -1; pe[i] = 0; }
    int k = 0, cur = -1, steals = 0, loud = 0;
    long next = 0, off = -1;
    for (long s = 0; s < 48000 * 6; s += 32) {
        if (s >= next && k < 24) { cur = 40 + k++; engine_note_on(cur, 100); off = s + 4800; next = s + 7200; }
        if (off >= 0 && s >= off) { engine_note_off(cur); off = -1; }
        engine_render(l, r, 32);
        for (int i = 0; i < ENGINE_VOICES; i++) {
            int n; float e;
            engine_voice_info(i, &n, &e);
            if (pn[i] >= 0 && n >= 0 && n != pn[i]) { steals++; if (pe[i] > 2e-3f) loud++; }
            pn[i] = n; pe[i] = e;
        }
    }
    CHECK(steals > 0, "no voice was stolen (test setup)");
    CHECK(loud == 0, "%d stolen voices switched note while still audible", loud);

    /* 4. STACK intervals: one voice, pure sines, no detune/drift/effects. Energy at
     * the expected partials of A3 (220 Hz): UNISON has no 440, OCTAVES does. */
    double unison440 = 0, unison220 = 0, oct[4] = { 0 };
    for (int mode = 0; mode < 2; mode++) {
        engine_init(48000);
        engine_set_param(P_ATTACK, 0.01f);
        engine_set_param(P_OSCS, 4); engine_set_param(P_STACK, mode ? 1 : 0);
        engine_set_param(P_DETUNE, 0); engine_set_param(P_DRIFT, 0); engine_set_param(P_SHAPE, 0);
        engine_set_param(P_SUB, 0); engine_set_param(P_SPREAD, 0); engine_set_param(P_CUTOFF, 12000);
        engine_set_param(P_FMOD_DEPTH, 0); engine_set_param(P_RESO, 0); engine_set_param(P_DRIVE, 0);
        engine_set_param(P_CHORUS, 0); engine_set_param(P_DLY_MIX, 0); engine_set_param(P_REV_MIX, 0);
        engine_note_on(57, 100);
        static float buf[48000];
        for (int s = 0; s < 48000; s += 32) engine_render(buf + s, r, 32);
        const double f[5] = { 110, 220, 440, 880, 330 };
        double e[5];
        for (int j = 0; j < 5; j++) {                 /* Goertzel over the last 0.5 s */
            double w = 2 * 3.14159265358979 * f[j] / 48000, c = 2 * cos(w), s1 = 0, s2 = 0;
            for (int i = 24000; i < 48000; i++) { double s0 = buf[i] + c * s1 - s2; s2 = s1; s1 = s0; }
            e[j] = sqrt(s1 * s1 + s2 * s2 - c * s1 * s2);
        }
        if (!mode) { unison220 = e[1]; unison440 = e[2]; }
        else for (int j = 0; j < 4; j++) oct[j] = e[j];
        if (mode) CHECK(e[4] < 0.05 * e[1], "OCTAVES: unexpected energy at 330 Hz");
    }
    CHECK(unison440 < 0.05 * unison220, "UNISON: energy at 440 Hz (%.3g vs %.3g)", unison440, unison220);
    CHECK(oct[0] > 0.2 * oct[1] && oct[2] > 0.2 * oct[1] && oct[3] > 0.2 * oct[1],
          "OCTAVES: missing partials (110 %.3g, 220 %.3g, 440 %.3g, 880 %.3g)", oct[0], oct[1], oct[2], oct[3]);

    /* 5. Shimmer: A3 held for 3 s. Each mode's shifted band (2-3 s) vs HALL's. */
    {
        static const double shifted[4] = { 0, 440, 329.6, 110 };
        static const char *const name[4] = { "HALL", "SHIM OCT", "SHIM 5TH", "SUB OCT" };
        const int a3 = 57;
        double hall[4] = { 0 };
        for (int mode = 0; mode < 4; mode++) {
            plain_setup(mode, 0.6f, 0.5f);
            run(&a3, 1, 3, 3.0f, -1, 0);
            if (!mode) {
                for (int m = 1; m < 4; m++) hall[m] = band(tl, 2 * SR, shifted[m]);
                continue;
            }
            double b = band(tl, 2 * SR, shifted[mode]), f0 = tone(tl, 2 * SR, 220);
            CHECK(b > 10 * hall[mode] && b > 0.05 * f0, "%s: shifted band %.4f (HALL %.4f, 220 Hz %.4f)",
                  name[mode], b, hall[mode], f0);
        }
        /* worst case for loop gain: 3-note chord, SIZE 0.75, DAMP 0, SHIMMER 100 % */
        const int chord[3] = { 45, 57, 64 };
        for (int mode = 1; mode < 4; mode++) {
            plain_setup(mode, 0.75f, 0.0f);
            run(chord, 3, 30, 1.0f, -1, 0);
            double early = rms(tl, 2 * SR), late = rms(tl, 29 * SR);
            CHECK(late < 0.01 * early, "%s: tail did not decay (rms %.4f at 2 s, %.4f at 29 s)",
                  name[mode], early, late);
        }
    }

    /* 6. FREEZE: switch at 2 s while the note sounds, release at 2.5 s. The
     * reverb holds (20 s vs 4 s); the same run in HALL dies away. */
    {
        const int a3 = 57;
        double hold[2];
        for (int f = 0; f < 2; f++) {
            plain_setup(0, 0.5f, 0.5f);
            run(&a3, 1, 21, 2.5f, f ? 2.0f : -1, 4);
            hold[f] = rms(tl, 20 * SR) / rms(tl, 4 * SR);
        }
        CHECK(hold[1] > 0.7, "FREEZE: level fell to %.3f of its 4 s value by 20 s", hold[1]);
        CHECK(hold[0] < 0.01, "HALL: level still %.3f of its 4 s value at 20 s", hold[0]);
    }

    /* 7. Velocity scales the note level; velocity 0 is a note off. */
    {
        const int one = 60;
        double lev[2];
        for (int j = 0; j < 2; j++) {
            int vel = j ? 127 : 20;
            plain_setup(0, 0.5f, 0.5f);          /* sines, reverb only but REV_MIX off below */
            engine_set_param(P_REV_MIX, 0);
            engine_note_on(one, vel);
            for (int s = 0; s < SR; s += 32) engine_render(tl + s, tr + s, 32);
            lev[j] = rms(tl, 0);
        }
        CHECK(lev[1] > 3.0 * lev[0], "velocity does not scale level (127 %.4g vs 20 %.4g)", lev[1], lev[0]);

        plain_setup(0, 0.5f, 0.5f);
        engine_set_param(P_REV_MIX, 0);
        engine_note_on(one, 0);                  /* velocity 0 = note off, must not sound */
        for (int s = 0; s < SR; s += 32) engine_render(tl + s, tr + s, 32);
        CHECK(rms(tl, 0) < 1e-6, "velocity 0 sounded (rms %.3g)", rms(tl, 0));
    }

    /* 8. Delay length: the echo lands at the set time, including a long (30 s)
     *    setting that only fits because DLY_N is large. */
    {
        static const int dly_ms[3] = { 300, 1500, 30000 };
        for (int j = 0; j < 3; j++) {
            plain_setup(0, 0.5f, 0.5f);
            engine_set_param(P_CHORUS, 0); engine_set_param(P_REV_MIX, 0);
            engine_set_param(P_SYNC, 0); engine_set_param(P_DLY_DIV, 0);
            engine_set_param(P_DLY_MIX, 1.0f); engine_set_param(P_DLY_FB, 0);
            engine_set_param(P_ATTACK, 0.002f); engine_set_param(P_RELEASE, 0.01f);
            engine_set_param(P_DLY_TIME, (float)dly_ms[j]);
            engine_note_on(60, 127);
            int off = (int)(0.01f * SR);
            int n = off + (int)(dly_ms[j] * 0.001f * SR) + SR / 4;
            for (int s = 0; s < n; s += 32) {
                if (s >= off && s < off + 32) engine_note_off(60);
                engine_render(tl + s, r, 32);
            }
            int from = (int)(0.05f * SR), pk = from;
            float pm = 0;
            for (int s = from; s < n; s++) {
                float a = tl[s] < 0 ? -tl[s] : tl[s];
                if (a > pm) { pm = a; pk = s; }
            }
            double want = dly_ms[j] * 0.001 * SR;
            CHECK(pm > 5e-3f && fabs((double)pk - want) < 0.03 * SR,
                  "delay %d ms: echo at %.0f ms (peak %.3g)", dly_ms[j], pk * 1000.0 / SR, pm);
        }
    }

    /* 9. Loop recorder: record a burst, stop (it loops), play it back with no
     *    voices, and overdub onto the same length. */
    {
        engine_init(SR);
        engine_set_param(P_LATCH, 0);
        engine_set_param(P_ATTACK, 0.002f); engine_set_param(P_RELEASE, 0.01f);
        engine_set_param(P_OSCS, 3); engine_set_param(P_DETUNE, 0); engine_set_param(P_DRIFT, 0);
        engine_set_param(P_SHAPE, 0); engine_set_param(P_SUB, 0); engine_set_param(P_SPREAD, 0);
        engine_set_param(P_CUTOFF, 12000); engine_set_param(P_FMOD_DEPTH, 0); engine_set_param(P_DRIVE, 0);
        engine_set_param(P_CHORUS, 0); engine_set_param(P_DLY_MIX, 0); engine_set_param(P_REV_MIX, 0);
        engine_set_param(P_VOLUME, 1.0f);
        const int rec = SR / 2;
        engine_loop_action(LOOP_CLEAR);
        engine_note_on(60, 127);
        engine_loop_action(LOOP_REC);
        for (int s = 0; s < rec; s += 32) {
            if (s >= 32 && s < 64) engine_note_off(60);
            engine_render(l, r, 32);
        }
        engine_loop_action(LOOP_REC);                 /* stop -> play */
        CHECK(engine_loop_len() == (uint32_t)rec, "loop length %u, want %d", engine_loop_len(), rec);
        CHECK(engine_loop_state() == LOOP_PLAYING, "loop state %d after rec", engine_loop_state());
        double e1 = 0, e2 = 0;
        for (int s = 0; s < rec; s += 32) { engine_render(l, r, 32); for (int i = 0; i < 32; i++) e1 += (double)l[i] * l[i]; }
        for (int s = 0; s < rec; s += 32) { engine_render(l, r, 32); for (int i = 0; i < 32; i++) e2 += (double)l[i] * l[i]; }
        CHECK(e1 > 1e-2, "loop playback silent (%.3g)", e1);
        CHECK(fabs(e2 - e1) < 0.25 * e1, "loop not periodic (%.3g vs %.3g)", e2, e1);
        engine_loop_action(LOOP_DUB);                 /* overdub keeps the length */
        for (int s = 0; s < rec; s += 32) engine_render(l, r, 32);
        CHECK(engine_loop_len() == (uint32_t)rec, "overdub changed the length to %u", engine_loop_len());
    }

    /* 10. Wavetable oscillator: the SAW table is band-limited, so a high note
     *     has no harmonics above its MIP level's cap (8 at note 100). */
    {
        engine_init(SR);
        engine_set_param(P_LATCH, 0);
        engine_set_param(P_WAVE, 1);                 /* SAW wavetable */
        engine_set_param(P_OSCS, 1); engine_set_param(P_DETUNE, 0); engine_set_param(P_DRIFT, 0);
        engine_set_param(P_SHAPE, 0); engine_set_param(P_SUB, 0); engine_set_param(P_SPREAD, 0);
        engine_set_param(P_CUTOFF, 20000); engine_set_param(P_FMOD_DEPTH, 0); engine_set_param(P_DRIVE, 0);
        engine_set_param(P_ATTACK, 0.005f); engine_set_param(P_RELEASE, 0.1f);
        engine_set_param(P_CHORUS, 0); engine_set_param(P_DLY_MIX, 0); engine_set_param(P_REV_MIX, 0);
        engine_set_param(P_VOLUME, 1.0f);
        engine_note_on(100, 127);
        for (int s = 0; s < SR; s += 32) engine_render(tl + s, tr + s, 32);
        double f0 = 440.0 * pow(2.0, (100 - 69) / 12.0);
        double lo = tone(tl, 0, 2 * f0);             /* inside the band */
        double hi = tone(tl, 0, 10 * f0);            /* above the level's 8 harmonics */
        CHECK(lo > 1e-3, "wavetable: no energy at 2*f0 (%.4g)", lo);
        CHECK(hi < 0.1 * lo, "wavetable: aliasing (2f0 %.4g, 10f0 %.4g)", lo, hi);
    }

    /* 11. FFT: fft -> ifft is the identity, and an impulse transforms to a flat
     *     spectrum (twiddle error from dsp_sin1 bounds the tolerance). */
    {
        fft_init();
        const int n = 1024;
        static float re[FFT_MAX], im[FFT_MAX], sr[FFT_MAX];
        for (int i = 0; i < n; i++) {
            re[i] = ((float)((i * 37) % 101) / 50.0f) - 1.0f;      /* -1..1, deterministic */
            im[i] = 0.0f;
            sr[i] = re[i];
        }
        fft(re, im, n, 0);
        fft(re, im, n, 1);
        float err = 0;
        for (int i = 0; i < n; i++) {
            float e = re[i] - sr[i]; if (e < 0) e = -e; if (e > err) err = e;
            if (im[i] < 0) { float q = -im[i]; if (q > err) err = q; } else if (im[i] > err) err = im[i];
        }
        CHECK(err < 0.02f, "FFT round trip error %.4g", err);

        for (int i = 0; i < n; i++) { re[i] = 0.0f; im[i] = 0.0f; }
        re[0] = 1.0f;
        fft(re, im, n, 0);
        float flat = 0;
        for (int k = 0; k < n; k++) {
            float e = re[k] - 1.0f; if (e < 0) e = -e; if (e > flat) flat = e;
            if (im[k] < 0) { float q = -im[k]; if (q > flat) flat = q; } else if (im[k] > flat) flat = im[k];
        }
        CHECK(flat < 0.02f, "FFT impulse not flat (max dev %.4g)", flat);
    }

    /* 12. Convolution: partitioned FFT convolution == direct FIR. */
    {
        static conv_t c;
        static float ir[1000], x[CONV_B * 6], out[CONV_B];
        fft_init();
        for (int i = 0; i < 1000; i++) ir[i] = (float)((i * 13) % 7 - 3) * 0.01f;
        for (int i = 0; i < CONV_B * 6; i++) x[i] = (float)((i * 29) % 17 - 8) * 0.05f;
        conv_init(&c, ir, 1000);
        float maxerr = 0;
        for (int blk = 0; blk < 6; blk++) {
            conv_process(&c, x + blk * CONV_B, out);
            if (blk < 2) continue;              /* the output lags the input by 2 blocks */
            int base = (blk - 2) * CONV_B;
            for (int j = 0; j < CONV_B; j++) {
                float s = 0;
                for (int k = 0; k < 1000; k++) {
                    int idx = base + j - k;
                    if (idx >= 0) s += ir[k] * x[idx];
                }
                float e = out[j] - s; if (e < 0) e = -e; if (e > maxerr) maxerr = e;
            }
        }
        CHECK(maxerr < 5e-3f, "partitioned convolution vs direct FIR: max err %.4g", maxerr);
    }

    /* 13. Convolution reverb (REV MODE = CONV): a short burst leaves a decaying
     *     tail after the dry note is gone. */
    {
        engine_init(SR);
        engine_set_param(P_LATCH, 0);
        engine_set_param(P_ATTACK, 0.002f); engine_set_param(P_RELEASE, 0.005f);
        engine_set_param(P_OSCS, 3); engine_set_param(P_DETUNE, 0); engine_set_param(P_DRIFT, 0);
        engine_set_param(P_SHAPE, 0); engine_set_param(P_SUB, 0); engine_set_param(P_SPREAD, 0);
        engine_set_param(P_CUTOFF, 12000); engine_set_param(P_FMOD_DEPTH, 0); engine_set_param(P_DRIVE, 0);
        engine_set_param(P_CHORUS, 0); engine_set_param(P_DLY_MIX, 0);
        engine_set_param(P_REV_MIX, 1.0f); engine_set_param(P_REV_MODE, 5);   /* CONV */
        engine_note_on(60, 127);
        for (int s = 0; s < SR; s += 32) {
            if (s >= 32 && s < 64) engine_note_off(60);
            engine_render(tl + s, tr + s, 32);
        }
        double tail = 0;                                   /* [0.05 s, 0.2 s] */
        for (int i = SR / 20; i < SR / 5; i++) tail += (double)tl[i] * tl[i];
        CHECK(tail > 1e-3, "CONV reverb: no tail after the note (%.3g)", tail);
    }

    /* 14. CONV reverb level: the IR is energy-normalised, so a full-wet CONV
     *     sits near HALL's level (a peak-normalised IR was ~5 dB hot and
     *     saturated the master tanh). */
    {
        static const int chord[4] = { 48, 52, 55, 60 };
        float pk[2];
        for (int mi = 0; mi < 2; mi++) {
            engine_init(SR);
            engine_set_param(P_LATCH, 0);
            engine_set_param(P_ATTACK, 0.002f); engine_set_param(P_RELEASE, 0.004f);
            engine_set_param(P_OSCS, 1); engine_set_param(P_DETUNE, 0); engine_set_param(P_DRIFT, 0);
            engine_set_param(P_SHAPE, 0); engine_set_param(P_SUB, 0); engine_set_param(P_SPREAD, 0);
            engine_set_param(P_CUTOFF, 12000); engine_set_param(P_FMOD_DEPTH, 0); engine_set_param(P_DRIVE, 0);
            engine_set_param(P_CHORUS, 0); engine_set_param(P_DLY_MIX, 0);
            engine_set_param(P_REV_SIZE, 0.75f); engine_set_param(P_DAMP, 0.4f);
            engine_set_param(P_REV_MIX, 1.0f);
            engine_set_param(P_REV_MODE, mi == 0 ? 0.0f : 5.0f);   /* HALL / CONV */
            for (int i = 0; i < 4; i++) engine_note_on(chord[i], 100);
            for (int s = 0; s < SR / 2; s += 32) engine_render(tl + s, tr + s, 32);
            float m = 0.0f;
            for (int i = SR / 4; i < SR / 2; i++) {
                float a = tl[i] < 0 ? -tl[i] : tl[i];
                if (a > m) m = a;
            }
            pk[mi] = m;
        }
        CHECK(pk[1] < pk[0] * 1.5f, "CONV reverb is too hot vs HALL (%.3f vs %.3f)", pk[1], pk[0]);
    }

    if (fails) printf("test_engine: %d FAILED\n", fails);
    else printf("test_engine: all passed (exp2 %.1e, %d steals faded, STACK partials, shimmer, freeze, velocity, delay, loop, wavetable, fft, conv, conv-reverb, conv-level ok)\n", worst, steals);
    return fails != 0;
}
