tthayer/rv_drone/(commit log)

2026-10-01 M0 scaffold: bare-metal boot for LicheeRV Nano, OpenSBI build, fip packaging
    - Architecture doc covering hardware, boot chain, runtime model, milestones
    - S-mode payload at 0x80200000: start.S, linker script, polled UART,
    rdtime heartbeat; BOARD=nano|qemu, verified on QEMU virt
    - tools/build-opensbi.sh: mainline OpenSBI v1.8.1 fw_dynamic with an
    embedded SG2002 DTB (FSBL passes no FDT)
    - tools/mkfip.sh: packs vendor FSBL + ddr_param + OpenSBI + payload via
    sophgo fiptool
    Not yet booted on hardware.
2026-10-02 docs: re-plan pins for LicheeRV-Nano-B from the 70405 schematic
    The earlier I2S2 pads (A28/A18/A19) have no IIS function. I2S2 is only
    reachable on the Ethernet footprint U7 (mux func 7). MIDI moves to UART3
    RX on P20 and the OLED to I2C3 on P22/P23. Adds the encoder allocation
    for 5 encoders with push switches, and the checks to do before wiring.
2026-10-02 Blink LED1 (A14) alongside the UART heartbeat
2026-10-02 docs: Ethernet path has series caps and magnetics; tap SoC side of C49/C50/C52
2026-10-02 docs: split into Nano (DSP) + Pico 2 W (I/O, audio clock) over SPI
    The Nano header has no usable I2S, so the RP2350 now drives the
    PCM5102A over PIO I2S, reads the encoders and MIDI, and drives the OLEDs
    (behind a TCA9548A mux). The Nano renders audio blocks and framebuffers,
    and the Pico pulls them over SPI1 with a DRQ line. Adds pin maps for both
    boards, the rvlink protocol, revised milestones, and the rejected audio
    paths.
2026-10-02 docs: 3 OLEDs split per encoder pair, 6 encoders, switches on MCP23017
2026-10-02 docs: three-board layout (Nano DSP, Pico A audio, Pico B panel)
    Splits the I/O across two Pico 2 Ws. Pico A only does audio (SPI1 rvlink
    + PIO I2S). Pico B runs the panel: 6 encoders on GPIO/PIO, 3 OLEDs on
    I2C0 (0x3C/0x3D) and I2C1, and MIDI, linked to the Nano over UART2 with
    COBS packets. Drops the TCA9548A and MCP23017. Adds pin maps for all
    three boards, the rvpanel protocol, and revised milestones. Updates the
    README.
2026-10-02 docs: audio link moves to SPI2 on P18/P21/P22/P23 (A22-A25 have no SPI)
    Checked against the SDK pinlist: the A22-A25 eMMC pads only mux to
    SPINOR/SPINAND. SPI2 (DW SSI, 0x041A0000) is the only SPI on the header.
    UART2 on A28/A29 (func 2) is confirmed. Adds an FMUX table for every Nano
    pin in use.
2026-10-02 M1: traps, PLIC, SBI timer tick, UART0 RX interrupt
    - trap.S/trap.c: stvec direct mode, a full GPR frame, dispatch on
    scause (STI → timer, SEI → PLIC). Faults dump scause/sepc/stval and
    halt (test with EXTRA_CFLAGS=-DM1_FAULT_TEST).
    - plic: hart 0 S-context, handler table, claim/complete loop.
    - timer: 1 kHz via SBI TIME, re-armed from the previous deadline (no
    drift).
    - uart: RX interrupt into an SPSC ring. main echoes received bytes and
    prints a tick line plus an LED toggle each second.
    Verified on QEMU virt. Hardware values (PLIC 0x70000000, UART0 IRQ 44)
    are not yet confirmed.
    [board_nano.h, main.c, plic.c, plic.h, timer.c]
2026-10-02 docs: MIDI input via M5Stack Unit MIDI (3.3 V opto output on Grove white)
2026-10-06 M1: clear DW UART busy-detect; add bring-up diagnostics
    The Nano hung after hello with no tick output. Suspected cause: a DW UART
    busy-detect interrupt storm (it only clears by reading USR). The UART
    setup and the ISR now read USR on DesignWare boards. Prints init markers,
    the UART regs, sip, and per-second PLIC claim/spurious/busy counts, plus a
    storm guard in plic_dispatch.
2026-10-06 docs: M1 verified on hardware (PLIC, UART0 IRQ 44, 25 MHz timebase, DW busy-detect)
2026-10-06 USB boot dev loop: tools/usbboot.py, make usbboot, Ctrl-R reset, C906L park
    - tools/usbboot.py speaks the SG2002 mask-ROM/FSBL USB download protocol
    (RAM only, no flash writes). Acks have timeouts, lost packets are
    resent, and it reconnects after USB drops.
    - `make usbboot` builds fip.bin, optionally sends Ctrl-R to RESET_PORT
    (UART0), then boots over USB. Needs USB_DL_MAGIC (vendor
    cv_dl_magic.bin) and pyserial.
    - board_reset(): RTC warm-reset sequence from vendor U-Boot (QEMU uses
    SBI SRST). main() resets on Ctrl-R.
    - build/park.bin: C906L parking loop that replaces the vendor cvirtos.bin
    as the fip RTOS image.
    Verified on hardware: Ctrl-R, ROM USB mode, image running, with no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
    [main.c, reset.c, usbboot.py]
2026-10-06 usbboot: open the ROM port immediately and retry the open fast
    The ROM gives up on USB download (USBEF), falls through to eMMC, fails,
    and resets if the host is slow to start after attach. A 1 s settle delay
    caused boot-fail loops. Now the open is retried every 50 ms, and termios
    errors are handled as drops. 512 B packets get CRC-mismatched acks from
    the FSBL, so 256 B stays the default.
    Measured: Ctrl-R to running image in about 20 s, with 1 reconnect.
    [usbboot.py]
2026-10-06 M2: Pico A firmware, PIO I2S 48 kHz/64 fs sine via double-buffered DMA
    - firmware/ Pico SDK 2.3.1 project (pico2_w); tools/get-pico-sdk.sh
    pins the SDK into third_party/.
    - audio: sysclk 153.6 MHz (VCO 1536 / 5 / 2), so PIO clkdiv is exactly
    25 (static_assert). Uses the pico-extras I2S program adapted to 32-bit
    slots: BCK GP10, LRCK GP11, DIN GP12.
    - Two chained DMA channels feed 64-frame blocks. The IRQ refills the
    finished block through fill_block(), the hook for the rvlink ring.
    USB CDC prints clocks plus blocks/s (750 expected) and late refills.
    - make pico / make pico-flash-audio. The toolchain is Arm GNU 15.3 with
    newlib (PICO_TOOLCHAIN_PATH).
    Not yet run on hardware.
    Co-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
2026-10-06 M3: Pico B panel firmware (encoders, switches, 3 OLEDs, MIDI)
    - 6 encoders through the pico-examples quadrature PIO program: pio0
    SM0-3 and pio1 SM0-1, deltas computed from absolute counts.
    - Switches: 1 kHz sampling, 5-sample debounce, lock-free event queue.
    - SSD1306 driver with per-page dirty tracking. Each OLED is split per
    encoder pair, refreshed at 30 Hz or less, and only displays that ACK
    are driven. Probe results are printed at boot.
    - MIDI on UART1 RX GP21: IRQ ring plus a running-status parser.
    - UART0 Nano link stub at 1.5625 Mbaud.
    - make pico-flash-panel, PICO_A_SER/PICO_B_SER, make test-panel (host
    tests: MIDI 27, debounce 136, render 5, all passing).
    Not yet run on ha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
2026-10-06 panel: fix boot livelock in encoder_read, real I2C probe, invert enc 1-5
    - encoder_read drained the RX FIFO "until empty". The SM pushes faster
    than the CPU reads, so boot could spin forever (timing-dependent). It
    now reads exactly level + 1 entries, as pico-examples does.
    - ssd1306_probe used a zero-length write, which the RP2xxx I2C block
    ACKs for every address. It now uses a 1-byte read.
    - enc_invert[]: the KY-040 modules (enc 1-5) count backwards relative to
    the bare encoder on enc 6.
    - main prints boot step markers.
    [encoders.c, main.c]
2026-10-06 README: fix current-state paragraph
2026-10-06 M4: rvlink over SPI2 (Nano master) / SPI0 (Pico A slave), test pattern
    - common/rvlink.h: 528-byte frame format, CRC-32 seal/check, test
    pattern.
    - Nano: pinmux, GPIO0 edge IRQ (DRQ on A27, PLIC 60), and a DW SSI
    master on SPI2 (P18/P21/P22/P23): mode 3, clk_spi 187.5 MHz / 24 =
    7.8125 MHz. CS is controller-driven, and the FIFO is kept fed with IRQs
    masked for each frame. audio_link sends test frames on DRQ and checks
    replies; per-second counters plus the measured transfer time.
    - Pico A: SPI0 slave with RX/TX DMA re-armed per frame (block reset, so
    no misalignment carries over). DRQ GP20 is raised per I2S block when
    armed. Frames are validated (CRC, magic, pattern, seq). The s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
    [audio_link.c, audio_link.h, board_nano.h, gpio.c, gpio.h, link_spi.c, link_spi.h, link_validate.c]
2026-10-06 M4 WIP: GPIO CS, level-qualified DRQ, header deps; link not yet clean
    Hardware findings:
    - SPI2 streams at 99% of SCK (7.76 of 7.81 Mbit/s), so there are
    essentially no gaps between bytes.
    - The controller CS blipped whenever the TX FIFO emptied, so P18 is now
    driven as PWR_GPIO_18 (gpio4 at 0x05021000) and held low for the
    frame, asserted before SSIENR and the prefill.
    - SCK crosstalk made false DRQ edges, so DRQ is now treated as a level,
    and edges latched during a frame are dropped.
    - Pico A side: a CS-rise blip check was added.
    - Makefile: -MMD/-MP header dependencies. Board constants were not
    triggering rebuilds before.
    - SPI temporarily at 1 MHz.
    Open issue: MISO arrives wit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
    [audio_link.c, audio_link.h, board_nano.h, link_spi.c, main.c, spi.c]
2026-10-06 M4: PIO SPI slave on Pico A; link clean at 7.8 MHz
    - Pico A: the PL022 slave is replaced by a 7-instruction PIO mode-3
    slave on pio1 (CS-gated; MISO on SCK fall, MOSI sampled on rise;
    autopush/pull 8 MSB-first; DMA both ways; full SM/FIFO restart per
    frame). The PL022 had slipped one bit after byte 0 on every frame.
    - Hardware result at SCK 7.8125 MHz: 733 frames/s, 0 CRC/magic/pattern
    errors on Pico A, and Nano replies valid. Transfers run at 99.5% of
    SCK. The ~17 missed DRQ/s come from the Nano's blocking 115200 stats
    print (~17 ms/s).
    - Makefile: the dependency include moved below the rules. Placed before
    'all' it had hijacked the default goal, so only one object rebuilt.
    -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
    [board_nano.h, link_spi.c, link_spi.h]
2026-10-06 M5 prereqs: async console, DRQ hold-off, tick-based short detection
    - Nano UART TX is now a 4 KB ring drained from the 1 kHz tick (at most
    16 B/tick into the empty FIFO). Prints never block. Fault and reset
    paths flush synchronously (uart_sync). The 17 ms blocking stats print
    had cost about 11 DRQs/s.
    - Nano DRQ edges are ignored during a frame and for 20 us after it. SCK
    crosstalk latched an edge that fired while Pico A still held DRQ high,
    starting an unrequested frame.
    - Pico A: the CS-rise IRQ is removed. It fired mid-frame on the
    breadboard and restarted the SM; the Nano saw the reply magic again,
    4 bits shifted, partway through. Short frames are now detected at the
    bloc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
    [audio_link.c, link_spi.c, main.c, timer.c, trap.c, uart.c, uart.h]
2026-10-06 docs: link soak clean after M5 prereqs (450k frames, 0 errors)
2026-10-06 Nano SPI2 DMA (DW AXI DMAC) working: 750 frames/s, IRQs stay enabled
    - DMAC at 0x04330000 (PLIC 29, int mux to the big core). SPI2 RX/TX
    handshakes 20/21 are remapped to slots 0/1. T-Head CMO (via .insn)
    provides cache clean/invalidate, with a probe and polled fallback.
    - The bug that stalled every DMA frame: the DMA channels were armed while
    the SSI was disabled. The TX request was already asserted, so the
    DMAC's first 16 bytes went into a FIFO held in reset. Pico A saw
    512-byte frames and the RX channel waited forever for the last 16.
    Fix: CS low, SER, SSIENR=1, DMACR, then arm DMA.
    - RX writes memory at 64-bit width as the vendor driver does. 1-item
    bursts and OSR 1 kept (co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
    [audio_link.c, audio_link.h, board_nano.h, cache.c, cache.h, dma.c, dma.h, main.c]
2026-10-06 docs: SPI DMA soak clean (450k frames, 0 errors); M5 prereqs done
2026-10-06 M5: Nano audio over rvlink into Pico A's ring (10 min soak clean)
    - Pico A: 8-block SPSC ring (audio_ring.h), primed to 4, silence and
    re-prime on underrun. Good non-test frames are pushed. DRQ is requested
    only below target, plus a catch-up request 30 us after a short frame
    (past the Nano's 20 us hold-off). The reply carries ring_fill and ring
    underruns. The local 440 Hz tone is removed.
    - Nano: 330 Hz float sine (tone.c, rotating phasor, no libm) rendered in
    main-loop context; trap.S does not save FP. sstatus.FS set. The 'p' key
    toggles the M4 test pattern.
    - Host test covers ring priming, order, underrun and overflow.
    Hardware: 10 min, 457k frames at 750/s, 0 CRC/DMA/SPI erro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
    [audio_link.c, audio_link.h, audio_ring.h, link_spi.c, link_spi.h, link_validate.c, link_validate.h, main.c]
2026-10-06 M6: rvpanel end to end (Nano UART2 <-> Pico B)
    - common/rvpanel.h: COBS + CRC-16/CCITT-FALSE packets. PAGE and CONFIG
    go from the Nano; ENC, SW, MIDI and STATUS from Pico B. Host test
    test_rvpanel covers round trips, corruption, resync and oversize.
    - Nano: UART2 driver (panel_link.c: 0x04160000, PLIC 46, 1.5625 Mbaud,
    RX IRQ decodes into an event queue, TX ring drained from the tick) and
    ui.c, which draws the 3 OLEDs and sends changed pages plus a full
    refresh every second. Panel stats go on the console.
    - Pico B: nano_link drives rvpanel (RX IRQ ring, events forwarded,
    STATUS once a second). The Nano's pages go straight into the
    framebuffers, with fallback to the local UI aft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
2026-10-06 M7 (in progress): drone engine, UI pages, emu host build
    - src/engine: 4 voices of 3-7 detuned oscillators (sine to polyBLEP saw,
    drift LFOs, sub), a stereo TPT SVF with LFO and saturator per voice,
    then chorus, cross-fed delay and an 8-line FDN reverb. dsp.h has
    libm-free exp2, sin, tanh and noise, so the host and the Nano render
    identically. params.c holds the 24-parameter table (curves, units,
    formatting, CC map).
    - src/ui: 4 pages of 6 parameters on the encoders. Enc 1 push changes the
    page; other pushes reset to default. Header shows page x/N, MIDI and
    CPU/voices. MIDI notes and CCs are routed to the engine.
    - src/app/panel_ui.c replaces app/ui.c (it now uses src/ui); tone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
    [main.c, panel_ui.c, panel_ui.h]
2026-10-06 M7: engine verified on hardware; 4 counts per encoder click
    - UI_COUNTS_PER_DETENT = 4: Pico B forwards raw quadrature counts, and
    every encoder (the KY-040s and the EC11) gives a full cycle per click.
    With 2, each click moved two steps.
    - Console key 'w' sets the worst-case load: OSCS 7, 4 latched voices.
    - Docs: M7 done. Worst case is 444 us per 64-frame block (33% of budget).
    The audio noise was a ground loop through the laptop charger.
    [main.c]
2026-10-07 M8 (in progress): SD0 driver, FatFs, presets on the SD card
    - src/hal/sd.c: polled SDHCI (DWC MSHC) driver for SD0. Clock gates,
    pads and pulls, the 3.3 V PWRSW and vendor PHY defaults follow the
    vendor Linux driver. Identify at 400 kHz, then 4-bit at 23.4 MHz;
    SDHC and SDSC; multi-block with auto CMD12. Waits call an idle hook,
    which keeps the audio link fed.
    - FatFs R0.15a, fetched and checksummed by tools/get-vendor.sh, with the
    project config in src/fs/ffconf.h (mkfs on, 8.3 names, no RTC), plus
    diskio glue.
    - Presets: ui.c stores P01..P16.TXT as text NAME=position lines through a
    ui_store_t (FatFs /presets on the Nano, build/emu/presets in emu).
    LAST.TXT picks the slot l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
2026-10-07 docs: WireViz wiring diagrams (system + panel) and the power plan
    - docs/wiring/system.yml: the PD trigger feeds a 5 V buck, which feeds a
    star point. That goes to Nano L13, each Pico's VSYS through a Schottky
    diode, and the PCM5102A through an RC filter. Also the rvlink SPI+DRQ,
    I2S, rvpanel UART and the FTDI console with its divider.
    - docs/wiring/panel.yml: Pico B to 6 encoders (5 KY-040 plus the EC11),
    3 OLEDs on I2C0/I2C1 and the Unit MIDI (5 V on VSYS).
    - Rendered .svg/.png are checked in; make wiring re-renders them.
    - ARCHITECTURE.md: links the diagrams and gives the single-supply power
    plan.
2026-10-07 docs: panel wiring notes EC11 (enc 6) has no external pull-ups
    [panel.bom.tsv]
2026-10-07 docs: CLAUDE.md rule to keep docs and wiring diagrams current; fix stale power rows
    - CLAUDE.md: update ARCHITECTURE.md, README and the WireViz diagrams in the
    same commit as any change that affects them, plus the dev-loop commands.
    - README PCM5102A VIN and the Unit MIDI 5 V row: development wiring now
    vs the single-supply build.
2026-10-07 tooling: pre-commit hook re-renders WireViz diagrams when their YAML changes
    - .githooks/pre-commit: on staged docs/wiring/*.yml, runs make wiring and
    stages the .svg/.png. Fails if WireViz or Graphviz is missing.
    - CLAUDE.md and README: the rule plus how to enable the hook
    (core.hooksPath).
2026-10-07 MIDI clock follower: tempo-synced filter LFO and delay
    - rvpanel CLOCK 0x85 {kind, t_us}. Pico B sends tick/start/continue/stop
    from the UART1 IRQ, stamped with time_us_32(). Every send is atomic
    (IRQs off per packet).
    - Nano: panel events carry the timestamp; panel_ui routes CLOCK to
    ui_clock and on to engine_clock. The console shows clock events and
    BPM.
    - Engine: tempo is the mean of 24 tick intervals. A beat position tracks
    the tick grid; Start re-zeroes it. New CLOCK page: SYNC (OFF/MIDI),
    LFO DIV (free, 1/4 beat to 8 bars), DLY DIV (free, 1/16 to 1/2, dotted
    values included). With no ticks for 0.5 s it falls back to free run.
    The header shows BPM. CCs 44-46.
    - UI: the l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
2026-10-07 README: emulator, host tests, SD/presets and console sections; current status
    The README had no mention of the emulator, and its status was stuck at M3.
    - Current state: M0-M7 done, M8 awaiting its power-cycle test, MIDI clock.
    - Toolchain: sdl2, graphviz, wireviz/numpy; get-vendor.sh.
    - New sections: Emulator (controls, offline --wav/--set/--clock), Host
    tests, SD card and presets (no fip.bin, format from the Nano, panel
    controls), Nano console commands.
    - Pico sections: Pico A console now, bench serials, Unit MIDI VSYS note,
    Pico B local UI is a fallback once the Nano sends pages.
2026-10-07 docs: ENGINE.md, full documentation of the Nano drone engine
    Covers signal flow, voices (allocation, latch), the oscillator bank, the
    TPT SVF with LFO and drive, the envelope, chorus, delay and FDN reverb,
    the MIDI clock follower, all 27 parameters (range, default, curve, CC),
    the UI pages, Nano integration (main-loop-only float, render timing,
    latency), CPU and memory budget, numerics, and how to extend it.
    Linked from the README and ARCHITECTURE.md; CLAUDE.md keeps it current.
2026-10-07 engine: oscillator-bank kernels (scalar + RVV/XTheadVector), probe, self-test, profiling
    - src/engine/osc.c: each voice's bank renders a whole control block into
    stereo buffers, with 32-bit fixed-point phases (exact wrap). The scalar
    kernel and the RVV kernel (GCC 16, -march=rv64gc_xtheadvector,
    __riscv_* intrinsics, 52 th.v* instructions) do the same math. Only
    osc.c and vec.c get the vector -march.
    - src/hal/vec.c: boot probe with th.vsetvli and a trap fallback. If the
    first try traps, it sets sstatus.VS (T-Head bits 24:23, then RVV 1.0
    bits 10:9) and retries. trap.c chains vec_probe_trap.
    - Nano: a boot self-test compares the scalar and RVV kernels; RVV is used
    only if they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
    [main.c, trap.c, vec.c, vec.h]
2026-10-07 Pico perf: hardware CRC + ring target 3 (Pico A); 1 MHz I2C, column ranges, core-1 display writer (Pico B)
    Pico A:
    - The DMA sniffer checks rvlink CRCs in hardware: CRC32R with output
    reversed and inverted, seed ~0, which is zlib's CRC-32. It runs on the RX
    channel; a good frame leaves the residue 0x2144DF1C. Replies are sealed
    through a mem-to-null DMA channel between frames. A boot self-test
    against rvlink_crc32 falls back to software CRC on any mismatch. Once a
    second one live frame is cross-checked in software (hw/sw-mismatch).
    - link_validate_crc() takes the verdict; link_build_reply_body() builds an
    unsealed reply. Host tests cover both plus the residue.
    - AUDIO_RING_TARGET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
    [audio_ring.h, fb.h, link_spi.c, link_spi.h, link_validate.c, link_validate.h, main.c]
2026-10-07 docs: drop stale WireViz HTML/BOM outputs and ignore them
    panel.html and panel.bom.tsv were committed by accident, and make wiring
    (-f sp) never regenerates them, so they had gone stale. Only the
    .yml/.svg/.png are tracked.
    [panel.bom.tsv]
2026-10-07 build: tune the Nano for the C906 (-march with T-Head extensions + -mtune=thead-c906)
    - C906_OPT=1 (default): -march=rv64imafdc_zicsr_zifencei_xthead* with
    -mtune=thead-c906, equivalent to -mcpu=thead-c906. GCC now emits indexed
    FP loads/stores (th.flrw/fsrw), conditional moves (th.mveqz/mvnez) and
    paired loads/stores (th.ldd/sdd), 516 T-Head instructions in total.
    These need mxstatus.THEADISAEE, which the FSBL sets (the CMO probe
    relies on it). The vector files use the same march plus _xtheadvector.
    - C906_OPT=0 builds generic rv64gc for A/B profiling. The boot banner
    shows the flavour ([c906] or [rv64gc]).
    - Makefile: a CFLAGS stamp forces a full rebuild when the flags change,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
2026-10-07 docs: ENGINE.md cache hierarchy and per-stage working sets
    The big C906 has a 128 KB L2 and the little core has none. Reverb (~70-85 KB
    live) and chorus fit the big core's L2; the delay (326-768 KB) streams from
    DDR. Implications: effects stay on the big core; the little core suits
    voice/oscillator work; new large-table features must fit within 128 KB.
2026-10-07 cpuclk: measure the C906 clock at boot; CPU_MHZ build option (default 1000 = MPLL/1)
    - src/hal/cpuclk.c: rdcycle against the 25 MHz rdtime over 2.5 ms, with a
    trap probe if S-mode can't read the cycle counter.
    - CPU_MHZ=1000 (default) moves the core from the TRM reset default
    (fpll/2 = 750 MHz, div_clk_c906_0_1) to MPLL/1 via div_clk_c906_0_0 and
    clk_sel_0[23]. It switches only if MPLL is powered, locked and computes
    to 900-1100 MHz (fractional or integer formula), and the core is not
    bypassed to the crystal. It re-measures and reverts if more than 10% off.
    CPU_MHZ=0 leaves the clock alone.
    - The boot banner prints before/after MHz and the clock/PLL registers;
    console c re-meas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
    [cpuclk.c, cpuclk.h, main.c, trap.c]
2026-10-07 panel link: interrupt-driven UART2 TX at full line rate; report UART clock and console baud
    - panel_link.c: the TX ring is now drained by the UART2 THR-empty interrupt
    in programmable-threshold mode (IER[7], FCR TX trigger 1/4 = 16 of 64
    bytes). Bursts stream at 1.5625 Mbaud instead of about 64 B/ms from the
    1 kHz tick (about 40% of the line rate). kick() starts a burst with SIE
    off. panel_link_tick is removed from the timer, and the console panel
    line shows txirq.
    - uart.c: uart_report_clock() reads the UART0 divisor and the
    clk_cam0_200 bypass and divider, then prints the console's real baud and
    error. Read-only.
    - Findings (SG2002 TRM Table 8.4 + vendor clk-cv181x.c): all UA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
    [main.c, panel_link.c, panel_link.h, timer.c, uart.c, uart.h]
2026-10-08 engine: pad reverb/delay buffers to stop cache-set aliasing (reverb 137 -> 62 us); hardware results
    Verified on hardware (C906 at 1050 MHz):
    - The RVV oscillator kernel runs and its self-test passes (max diff 1.8e-7).
    The vector unit was off at boot and is enabled via sstatus.VS[24:23].
    osc 136 -> 28 us at the worst case (4.9x).
    - -mcpu=thead-c906 tuning: no measurable difference (387 vs 387 scalar,
    278 vs 279 RVV).
    - Reverb was cache-set bound: 8 power-of-two rows written at the same index
    collided in one set (about 130 ns per access). REV_PAD (one line per row)
    and DLY_PAD between delay L/R give reverb 137 -> 62 us and a worst-case
    total of 278 -> 202 us (15%), with bit-identic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
    [cpuclk.c, uart.c]
2026-10-08 docs: MIDI clock follower verified on hardware with the MicroFreak
    The MicroFreak sends clock only while its arp/seq plays (Output dest MIDI or
    BOTH). 70 ticks/s reach Pico B, the Nano tracks 176 BPM with the transport
    running, and LFO DIV locks the filter sweep audibly.
2026-10-08 ui: PRESET page previews the selected slot's stored settings on display 2
    The right display now shows what the slot holds, read from its file:
    cutoff/reso, shape/detune, oscs/sub, delay (time or sync division)/feedback,
    reverb/size, attack/release. EMPTY, NO CARD and BAD FILE are shown when
    there's nothing to preview, and the load/save message moves to its header.
    The preset parser is split out (parse_preset/read_preset) and shared by
    load and preview. The file is read on page entry, slot change and save,
    never from ui_draw. Layout checked with a host render.
    Docs: README presets section, ENGINE.md UI paragraph, ui.h comment.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
2026-10-08 engine: start silent (no boot drone) now that MIDI drives the notes
    engine_init() no longer latches D2 + A2; nothing plays until a note
    arrives. emu --wav defaults to --notes 38,45 so offline renders and
    make emu-wav keep their drone; --notes "" renders silence (checked: peak
    -240 dBFS). Docs: ENGINE.md voices, ARCHITECTURE engine summary, header
    comments.
    [main.c]
2026-10-08 docs: drop stale WireViz HTML/BOM outputs and ignore them
    The same cleanup as on pico-perf: panel.html and panel.bom.tsv were
    committed by accident and never regenerated by make wiring (-f sp).
    [panel.bom.tsv]
2026-10-08 engine: vectorised voice path, 16 voices, and output gain staging
    - src/engine/voice.c: lane kernel (scalar + RVV). Each active voice is two
    lanes (L/R), up to 32; per sample, the TPT SVF, saturator and envelope run
    across all lanes. Chunks of 8 lanes (e32/m2) keep state and coefficients in
    registers for the block. The sub-oscillator runs as a one-oscillator sine
    bank through the osc kernel.
    - ENGINE_VOICES 4 -> 16. Voice-sum gain is 1 up to 4 voices, then 2/sqrt(n),
    smoothed. The filter-LFO rate/phase spread keeps voices 0-3 as before and
    interleaves the rest.
    - Output gain staging: OUT_GAIN 1.5 -> 0.4 before the soft clipper (the
    measured worst case was 2.7x full scale pre-cl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
    [main.c]
2026-10-08 nano: per-channel output peak meter; document link noise in the analog output
    - main.c: render_block tracks the largest |sample| sent per channel; the
    console prints 'out: peak L R' each second.
    - Finding: the right-channel high-pitched tone with the engine silent is
    electrical. The Nano sends exact zeros (peak L 0 R 0); the tone stops when
    the link is idle (Nano in reset) and persists with Pico B and the OLEDs
    unpowered, so it is coupling of the SPI2 bursts/DRQ edges into the DAC
    output, previously masked by the boot drone. ARCHITECTURE lists the wiring
    fixes and untried software mitigations. README documents the console line.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
    [main.c]
2026-10-08 docs: ARCHITECTURE known issue, link noise in the analog output (fixes e512e66)
    e512e66 meant to add this section but its edit missed its anchor (the
    pico-perf latency text, not on this branch) and silently did nothing.
    It also records the hardware result: fitting the Pico B <-> Nano ground cut
    the tone a lot.
2026-10-08 nano: console P dumps every engine parameter; ENGINE_VOICES overridable; noise issue mostly resolved
    - main.c: the P key prints each parameter's current formatted value (six
    per line) for on-hardware diagnosis. README console table updated.
    - engine.h: #ifndef ENGINE_VOICES so host tests can build 4- and 16-voice
    engines for A/B comparison.
    - ARCHITECTURE: the link-noise known issue is marked largely resolved; more
    board-to-board grounds almost eliminated it.
    [main.c]
2026-10-08 docs: resolved ground loop with the MicroFreak (same USB power source)
    Noise only while a key was held, worse when a ground wire was touched: a
    ground loop through MIDI and audio between separately powered instruments.
    Powering the MicroFreak from the same USB source as rv_drone resolved it.
2026-10-08 engine: stolen voices fade out (30 ms) instead of cutting off; fix exp2/envelope accuracy
    - Voice stealing picks the quietest releasing voice (else the quietest held
    one; ties go to the oldest), fades it over STEAL_FADE_S = 30 ms, then
    starts the queued note with fresh phases. Near-silent voices switch at
    once. A note-off cancels a queued note; all-off clears queues. Adds
    engine_voice_info() (read-only).
    - Bug found while testing: dsp_exp2 used Taylor coefficients (rel error up
    to 1e-4 near f = 1), so 1 - 2^(-tiny) envelope coefficients were wrong
    and every long ATTACK/RELEASE was about 6x too short (RELEASE 4 s behaved
    like ~0.6 s). Now a degree-6 minimax fit (8e-8), and coef_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
    [test_engine.c]
2026-10-08 engine: OSCS up to 16 and STACK modes (unison/octaves/fifths/organ); preset v2
    - OSC_MAX 7 -> 16; osc_norm extended (~1/sqrt n). STACK (CC 47, on the
    CLOCK/STACK page) gives each oscillator an interval and weight from a
    cycling table: UNISON, OCTAVES (0 +12 -12 +24), FIFTHS (0 +7 +12 +19 -12
    +24) or ORGAN (drawbar footages). Oscillators above 0.45 fs are muted,
    not mistuned.
    - Presets carry a 'preset v2' header; v1 files are converted so OSCS keeps
    its oscillator count on the wider range.
    - On the Nano, plain-C mode caps OSCS at 7: uncapped 16x16 scalar took
    ~1795 us (134%, not real-time); capped it takes ~1001 us (75%). RVV 16x16
    takes 648 us (48%). Console 'a' = all notes off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
    [main.c, test_engine.c, test_presets.c]
2026-10-08 README: Unit MIDI 3.5 mm input is verified, not unverified
2026-10-08 docs: correct the Unit MIDI 3.5 mm note: MicroFreak TRS Type B doesn't work straight
    Reverts the wrong 'verified' claim from 6e71d68/bd03ff6 (MIDI had been
    arriving via the DIN input, not 3.5 mm). The MicroFreak is TRS Type B;
    a straight 3.5 mm cable into the Unit MIDI fails, consistent with Type A
    on the Unit side. Use the MicroFreak's TRS-to-DIN adapter into DIN, or a
    Type A<->B converter. Keeps the correct M9-headroom update.
2026-10-08 docs: M8 done: presets survive a Nano power cycle
2026-10-08 docs: pico-perf verified on hardware (Pico B 1 MHz I2C, Pico A ring 3)
2026-10-08 Pico B: animated boot splash on the OLEDs until the Nano takes over
    Title, booting line, elapsed seconds and a three-sine drone wave that swells
    in and scrolls across all three displays. Returns while the Nano is silent;
    an encoder or switch swaps it for the local test UI. Host test renders it.
    [main.c, render.c, render.h]
2026-10-08 docs: keep the 25 MHz UART clock; the console works at -3.1 %
2026-10-08 engine: REV MODE (HALL, SHIM OCT, SHIM 5TH, SUB OCT, FREEZE) and SHIMMER
    A two-tap Hann-crossfaded delay-line pitch shifter on the reverb's wet sum,
    band-limited and fed back into the FDN; feedback is capped below the measured
    runaway point. FREEZE mutes the reverb input and holds the tail. Both new
    params sit on the last page, renamed MODES (CC 48, 49). engine_init now
    clears all state so re-inits start silent. Host tests cover the shifted
    bands, worst-case decay and freeze hold.
2026-10-08 engine: shimmer as a per-block pre-pass, skipped in HALL/FREEZE; console 'r' cycles REV MODE
    Measured on the Nano: reverb stage 67 us/block in HALL/FREEZE, 79-80 us in the
    shimmer modes. Docs: CPU cost, the 'r' key.
    [main.c]
2026-10-08 docs: worst case with shimmer measured (667 us, 50 %); fix the 'w' key message
    [main.c]
2026-10-08 docs: A29 already has its internal pull-up by default; the errors were Pico B unpowered
2026-10-08 Check hardware claims against the SG2002 TRM
    - uart.c: div_clk_cam0_200 src 1 = DISPPLL (TRM), not 2 (vendor parent list)
    - sd.c: decode clk_sd0 from CLKGEN instead of assuming the DTS 375 MHz (TRM
    preset is 100 MHz); dividers use the larger value; sd: line reports it
    - board_nano.h, plic.c, dma.c: replace UNVERIFIED tags with TRM references
    (memory map, C906 interrupt table, clock/reset/DMA tables); note what the
    TRM does not cover (pad FMUX values, PLIC layout, timebase)
    - ARCHITECTURE.md: the Unverified list becomes a TRM check summary
    [board_nano.h, dma.c, plic.c, preset_fs.c, sd.c, sd.h, uart.c]
2026-10-15 nano: in-place firmware update over UART0 ('u')
    The console 'u' command receives a fip.bin over UART0, stages it as /fip.new on the SD card, verifies size and CRC-32 (and re-reads the staged file), swaps it over /fip.bin and reboots. The old image is left untouched on any failure and the card never leaves the board. 'make upload' drives it; verified on hardware (2026-10-12).
    For speed the transfer raises UART0 to divisor 2 (781250 baud) and stops feeding the audio link (engine silent until the reboot). The result is reported back at the console baud, where the host reads it reliably - divisor 1 (1.5625 Mbaud) carries the data but an FT232R cannot hold its return path. FW_UPLOAD_DIV override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
2026-10-15 engine: enable MIDI note velocity
    Each voice carries a velocity gain (1/127..1), set at note-on and used as the envelope peak, so harder notes are louder. Scaling the envelope target (not the oscillator or kernel output) leaves voice.c/voice.h untouched, so the scalar/RVV math parity is preserved.
    The map is linear (about 42 dB): a squared curve would push low velocities under the envelope thresholds used elsewhere (a voice is freed below 1e-4, and 1e-3 bounds the steal fade), so the quietest note would read as already silent. The steal path carries the pending note's velocity too.
    - src/engine/engine.c: vel/pending_vel on voice_t, vel_gain(), velocity-scaled env_target
    - emu/test_engine.c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
2026-10-15 engine: long delay (spare DDR) — part 1 of #2
    Raise the feedback delay to 2^23 samples per channel (~175 s, 64 MiB stereo) and widen DELAY to 20 ms-120 s. The mask math and the 32-bit write counter are unchanged, so only the buffer size and the clamp change. The delay streams sequentially from DDR, so the per-block CPU cost is unchanged.
    - src/engine/engine.c: DLY_N 131072 -> 8388608; clamp the target to the buffer
    - src/engine/params.c: DELAY max 2 s -> 120 s
    - src/boot/link.ld: RAM window 64M -> 224M (DTS memory node is 0x80000000..0x8FE00000); .bss is NOLOAD so fip.bin stays ~360 KB
    - emu/test_engine.c: delay-length round-trip test, including a 30 s setting
    - docs/ENGINE.md, docs/CONTR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
2026-10-15 engine: loop recorder (spare DDR) — part 2 of #2
    Record the post-effects output into a 2^22-frame buffer (~87 s, 32 MiB stereo), loop it, and layer overdubs. The LOOPER page drives the transport; loops stream to/from the SD card as raw float32.
    - src/engine: loop buffer + transport (REC/PLAY/DUB/STOP/CLEAR), capture + playback in the effects path, buffer accessors for SD I/O
    - src/ui: LOOPER page (SLOT/REC, PLAY/DUB, SAVE/LOAD) and ui_loop_store_t
    - src/app/preset_fs: LOOP0n.RAW save/load via the root-file streaming API; main.c wires the store
    - emu/main.c: a build/emu/loops/ store; test_engine.c: record -> loop -> periodic -> overdub
    - docs/ENGINE.md, docs/CONTROLS.md, docs/ARCHITECTURE.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
2026-10-15 tools: auto-retry the in-place upload; docs for #1/#2
    The in-place transfer has no flow control and occasionally drops a byte (a slow card write stalls the reader), which aborts it. upload-fip.py now retries the whole attempt (--retries, default 3); it is safe - the old /fip.bin is untouched until the staged copy verifies.
    Docs: README (the retry, plus the long delay and loop recorder in the feature list); CLAUDE.md dev loop.
    Refs #2.
2026-10-15 engine: sample/wavetable oscillators (spare DDR) — #3
    Add band-limited single-cycle wavetables as a new oscillator source (the WAVE parameter). Each table has 10 MIP levels (harmonic caps 512..1); the oscillator picks the level whose harmonics stay under Nyquist for its pitch, so high notes do not alias.
    - src/engine/osc.{c,h}: the table store (SAW/SQUARE/ORGAN + CUSTOM), per-octave level select, and a scalar lookup path. The RVV kernel falls back to the scalar lookup for wavetable oscillators (XTheadVector exposes no indexed load), so the analytic path keeps its RVV kernel + self-test
    - src/engine/{engine.c,params.h,params.c}: WAVE parameter (new page 6) and wiring; CC 50
    - src/app/prese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
2026-10-15 app: turn off the Nano LED heartbeat
    LED1 (pad A14) no longer blinks: led_init drives it to the off level (kept a driven output, not high-Z) and the main-loop toggle is removed.
2026-10-15 tools: add nano.py (flash/console/wait); drop upload-fip.py
    tools/nano.py uploads fip.bin in place over UART0 (retries, waits for the board and the reboot) and reads the console; make upload drives it. Fixes a real bug: the baud switch back to the console used to reset the input buffer, discarding the firmware's 'fwup: done' so a successful write reported as a timeout. README/CLAUDE updated; tools/upload-fip.py removed.
2026-10-15 engine: radix-2 FFT (issue #4, stage 1)
    A freestanding float FFT (no libm): radix-2, in-place, forward/inverse, twiddles built from dsp_sin1. Scalar only for now - XTheadVector has no cheap lane permute for the butterflies - documented. Foundation for the partitioned IR convolution (#4) and the spectral effects (#5).
    - src/engine/fft.{c,h}: fft_init() + fft(re, im, n, inverse)
    - Makefile: build it (Nano, emulator, host tests)
    - emu/test_engine.c: FFT round-trip identity + impulse -> flat spectrum
    Refs #4.
2026-10-15 engine: partitioned FFT convolution (issue #4, stage 2a)
    Uniform partitioned overlap-save convolution on the radix-2 FFT: the IR is split into CONV_B (512) sample partitions, each transformed once; the live signal is convolved block by block, one block of latency. Mono IR; one instance per channel. This is the reverb core - wiring it as a REV MODE and loading IRs from SD is the next stage.
    - src/engine/conv.{c,h}: conv_init() + conv_process()
    - emu/test_engine.c: partitioned convolution vs a direct FIR (max err < 5e-3)
    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
2026-10-15 engine: convolution reverb as a REV MODE (issue #4, stage 2b)
    REV MODE gains CONV: the reverb send is convolved with an impulse response via the partitioned FFT convolver instead of the FDN. A built-in synthetic IR (decaying noise, ~170 ms) is used for now - loading an IR file from the SD card is the next step.
    - src/engine/engine.c: stereo conv-reverb state + per-sample block staging, wired into the reverb pass
    - src/engine/params.c: REV MODE gains CONV (6 values)
    - emu/test_engine.c: CONV mode leaves a reverb tail after the note
    - docs/ENGINE.md, docs/CONTROLS.md
    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
2026-10-15 engine: load the CONV reverb IR from the SD card (issue #4, stage 3)
    /IR.RAW at the card root (mono float32, any length, normalised to peak 1) is loaded at boot and installed into the CONV reverb, replacing the built-in synthetic IR. engine_ir_set() rebuilds both channels' partitioned spectra.
    - src/engine/engine.{c,h}: engine_ir_set()
    - src/app/preset_fs.{c,h}: preset_fs_ir_load() (reads /IR.RAW, normalises)
    - src/app/main.c: load it at boot
    - docs/ENGINE.md, docs/CONTROLS.md, README.md
    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
2026-10-15 fix: boot trap - simd_selftest left osc_bank_t.wt[] uninitialized
    simd_selftest() built its random osc_bank_t but never set wt[] (the wavetable pointer array added in #3), so osc_bank_scalar() followed a stale stack pointer and the board took a load-access fault (scause=5, sepc in osc_bank_scalar) and halted during boot. Latent since #3; exposed by the .bss/stack shift from the CONV reverb state.
    Also: conv_init() now calls fft_init() itself - the Nano build never called fft_init(), so the FFT twiddles were all zero (host tests passed only because test_engine.c calls it explicitly).
    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
2026-10-15 engine: normalise the CONV IR by energy; fix the console 'r' cycle
    The built-in IR was normalised to peak 1, but for a reverb what matters is energy: an 8192-sample decaying noise at peak 1 has |H| ~ 19, so CONV's wet measured ~5 dB hotter than HALL at the same REVERB and saturated the master tanh (a 4-note chord peaked 0.354 vs HALL's 0.201 at mix 1). Normalise by energy to a fixed target (CONV_IR_GAIN) so the wet level is independent of the IR's length/density; CONV now sits within ~2 dB of HALL (0.245 vs 0.201). engine_ir_set applies the same rule to a loaded IR, so preset_fs_ir_load no longer peak-normalises. Host test 14 guards the level.
    The console 'r' helper hardcoded 5 REV MODEs, s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
2026-10-15 engine: spread the CONV partition MACs across render blocks (fix dropouts)
    The convolution did all its work in the render block where the 512-sample input buffer filled: 2 FFTs + CONV_P complex MACs per channel, streaming ~512 KB, measured at ~4-6 ms in one 64-frame block (budget 1333 us). The average looked fine (528 us/block, load 43%) but the peak starved Pico A ~39 times a second even at idle, which is the audible crackle.
    conv_step() is now one sample in / one sample out and spreads the MACs: one partition every CONV_B/npart samples after each input block. The forward FFT stays on the input-block boundary and the inverse FFT runs when the last partition lands, so the wet lags the dry b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
2026-10-15 engine: apply the scalar OSCS cap to wavetable oscillators too
    A wavetable oscillator (WAVE != ANALOG) runs the scalar lookup on both kernels - XTheadVector has no indexed load - so it costs like the scalar path, but the SCALAR_MAX_OSC cap only checked E.simd. Uncaught, 16 voices x 16 osc with a wavetable plus the CONV reverb measured 1880 us per block (141% of the 1333 us budget, osc alone 869 vs 267 us analytic) and dropped audio; HALL alone or ANALOG+CONV each stay under. nosc is now capped when E.p[P_WAVE] > 0 as well (~1000 us, 75%).
    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
